su-keerthi/5_Bit_Carry_Lookahead_Adder/Report/VLSI COURSE PROJECT.pdf

VLSI COURSE PROJECT

CARRY LOOK-AHEAD ADDER

Sukeerthi Kattamuri

Roll No. 2024102074

I. INTRODUCTION

Addition is a fundamental operation required in digital circuits. One common approach for performing addition is the ripple-carry adder, where the carry output from each full adder is passed to the next stage. However, this introduces significant propagation delay because every stage must wait for the carry from the previous one.

To overcome this delay, a carry look-ahead adder (CLA) is used. In a CLA, carries are computed directly from the input bits using digital logic. This avoids the sequential delay seen in ripple adders and results in much faster computation

The basic circuit diagram is given below

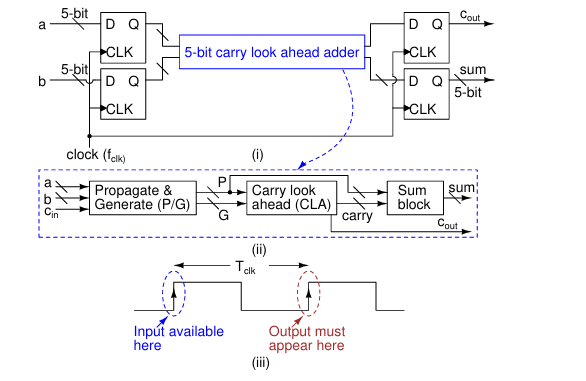
[picture p1: figure]

CLA uses two signals for each bit position:

Propagate: Pi = Ai ⊕ Bi

Generate: Gi = Ai · Bi

Using these signals, the carry-out of each stage is expressed as: Ci+1 = Gi + Pi · Ci. We can recursively calculate the carry bit for each bit using this formula as done below.

C1 = g1 + p1·C0

C2 = g2 + p2·C1 = g2 + p2·g1 + p2·p1·C0

C3 = g3 + p3·C2 = g3 + p3·g2 + p3·p2·g1 + p3·p2·p1·C0

C4 = g4 + p4·C3 = g4 + p4·g3 + p4·p3·g2 + p4·p3·p2·g1 + p4·p3·p2·p1·C0

C5 = g5 + p5·C4 = g5 + p5·g4 + p5·p4·g3 + p5·p4·p3·g2 + p5·p4·p3·p2·g1 + p5·p4·p3·p2·p1·C0

Once the carries are computed, we can calculate all the sum bits.

Si = Pi ⊕ Ci−1

IIA. CLA DESIGN TOPOLOGY

Here we use static CMOS implementation to make the required logic gates. We require multiple input gates for preforming these computations. This can either be implemented by using a single multiple input gate or by using multiple dual input gates. After analysis of ngSpice simulation, there was less delay from using dual input gates. Hence all the required gates AND(input 2, 3, 4, 5, 6), OR(input 2, 3, 4, 5, 6), NOT and XOR were implemented using static CMOS logic.

The reason for preferring this logic style over other dynamic styles is that we require for the output to be computed within one clock cycle, this is difficult to achieve through dynamic implementations. Dynamic logic also has the risk of charge leakage. Also dynamic logic requires a precharge and evaluation phase which lead to excessive power consumption that is not preferred.

Other advantages of the CMOS style are its simple and straightforward design. Moreover it has high noise margins, giving a more robust implementation.

The basic circuit that we used can be divided into three blocks. The first block consists if flip-flops. The implementation used here is a TSPC (True Single Phase Clock) flip-flop. The flip-flop ensures that the input bits are all given simultaneously to the adder to prevent any glitches. In the next stage, the logic signals discussed above are implemented using static CMOS designed gates. The carry bits are all computed simultaneously without needing to wait for previous computations. Once the sum bits and final carry bit is generated, they are stored in another set of flip-flops, so that the results can be used at the next rising clock edge.

The circuit implemented for the TSPC is flip-flop is given below.

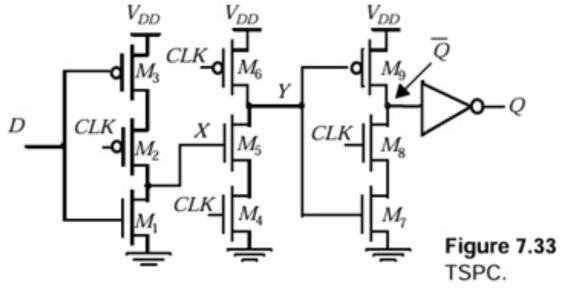
[picture p2: figure]

II.B CLA TRANSISTOR SIZING

Minimum sizing MOSFETS are used. λ = 0.09 μm is taken. We are required that for the NOT gate WP / WN = 2.

OR gates are implemented by using a NOR gate followed by an inverter and similarly AND gates are implemented using a NAND gate followed by an inverter.

Gate | NMOS | PMOS
NOT | 900 nm | 1800 nm
NOR – 2 input | 900 nm | 3600 nm
NOR – 3 input | 900 nm | 5400 nm
NOR – 4 input | 900 nm | 7200 nm
NOR – 5 input | 900 nm | 9000 nm
NOR – 6 input | 900 nm | 10800 nm
NAND – 2 input | 1800 nm | 1800 nm
NAND – 3 input | 2700 nm | 1800 nm
NAND – 4 input | 3600 nm | 1800 nm
NAND – 5 input | 4500 nm | 1800 nm
NAND – 6 input | 5400 nm | 1800 nm
XOR – 2 input | 1800 nm | 3600 nm
TSPC Flip Flop | 900 nm | 1800 nm

III. NSPICE SIMULATIONS

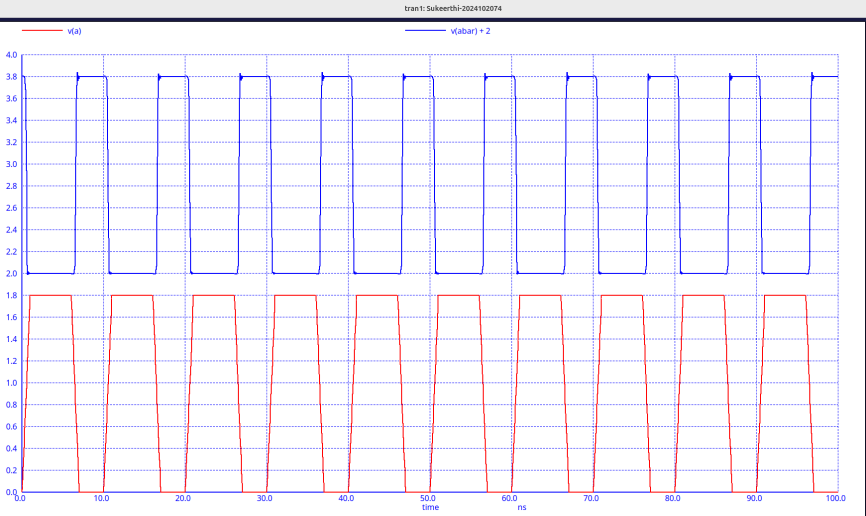
[picture p3: figure]

Inverter

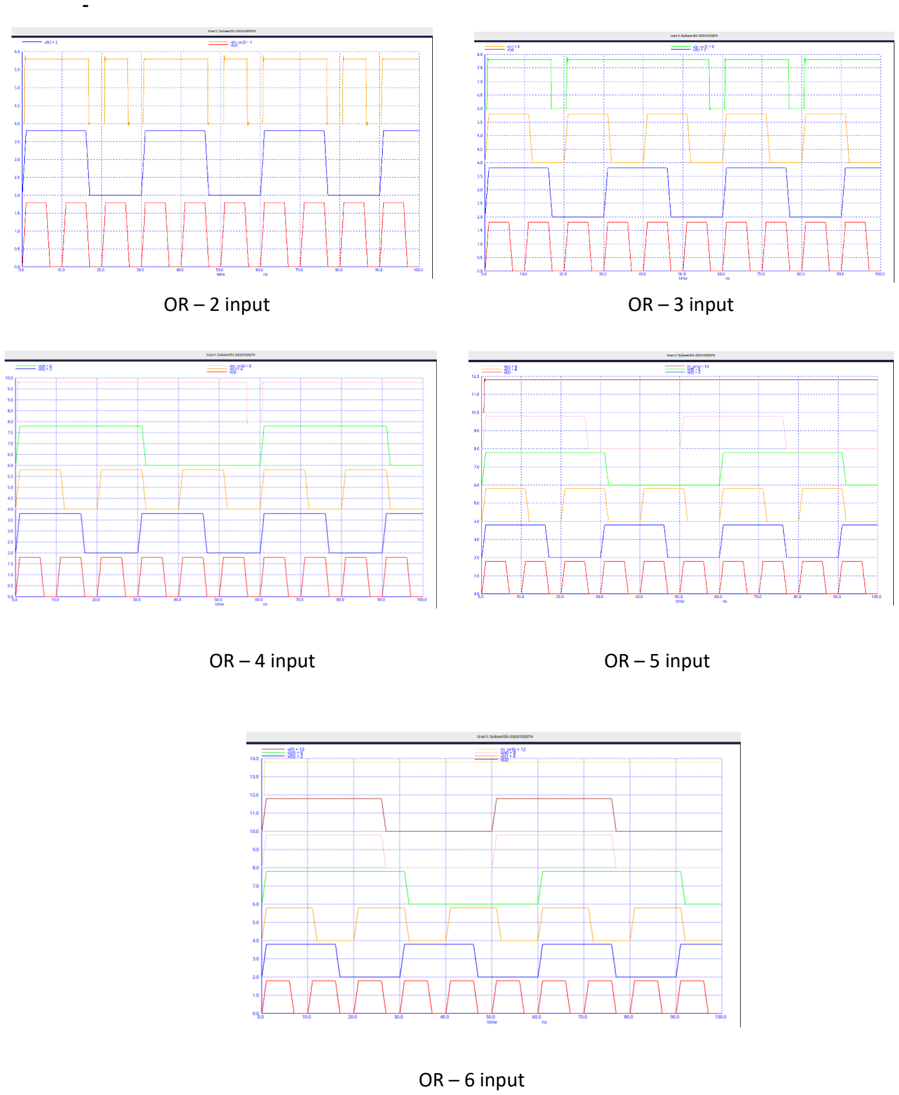
[picture p4: page 4]

OR – 2 input | OR – 3 input
OR – 4 input | OR – 5 input

OR – 6 input

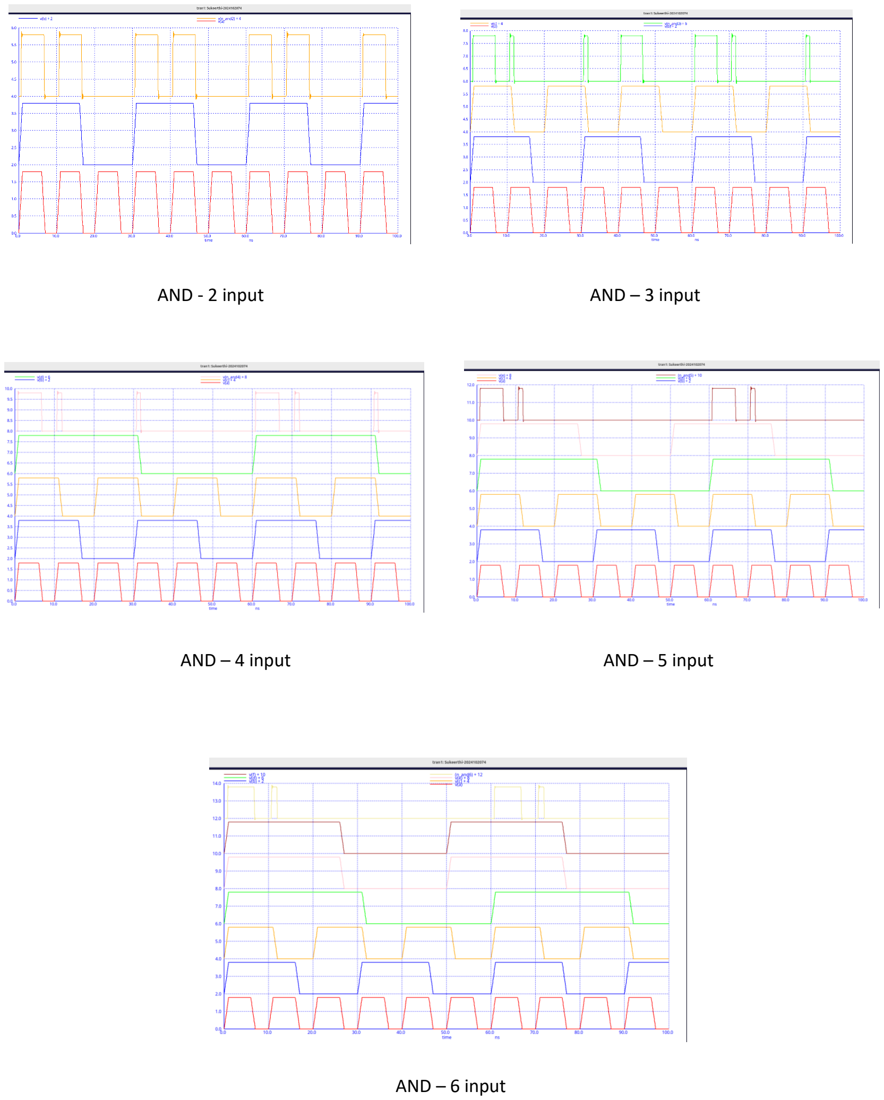
[picture p5: page 5]

AND - 2 input | AND – 3 input
AND – 4 input | AND – 5 input

AND – 6 input

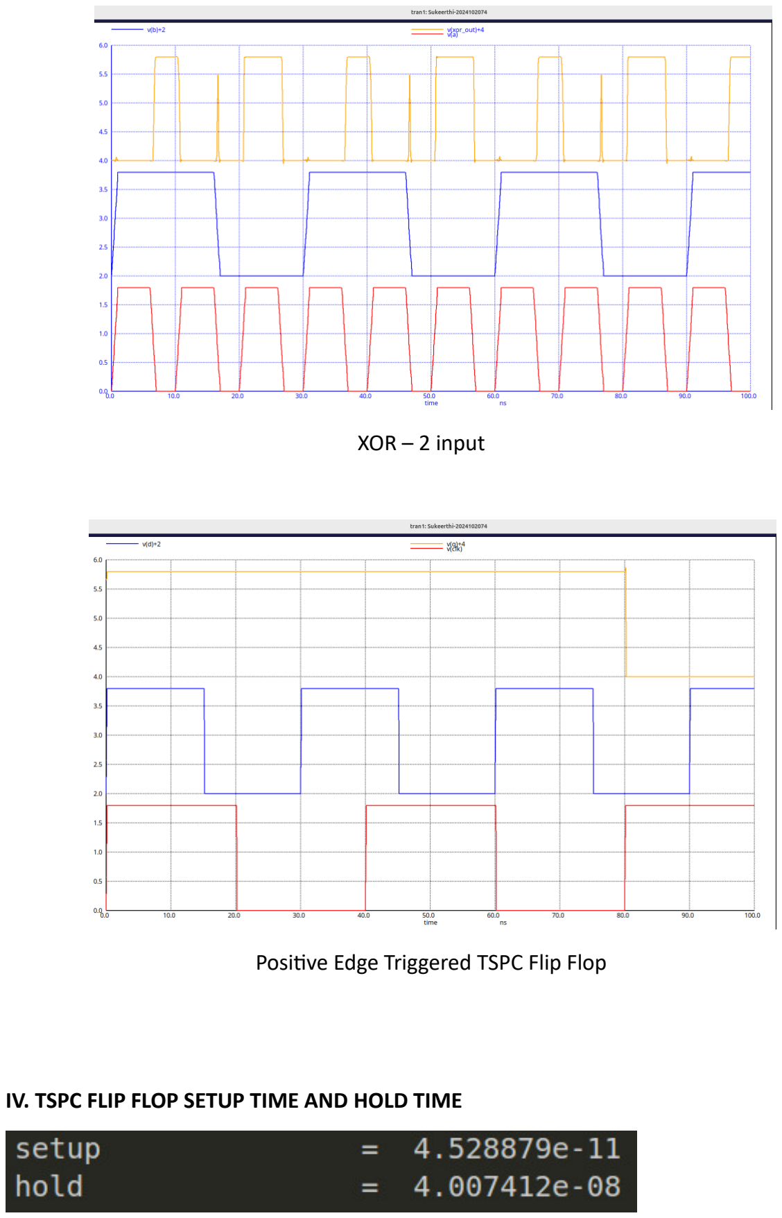
[picture p6: page 6]

XOR – 2 input

Positive Edge Triggered TSPC Flip Flop

IV. TSPC FLIP FLOP SETUP TIME AND HOLD TIME

V. STICK DIAGRAMS FOR IMPLEMENTATION

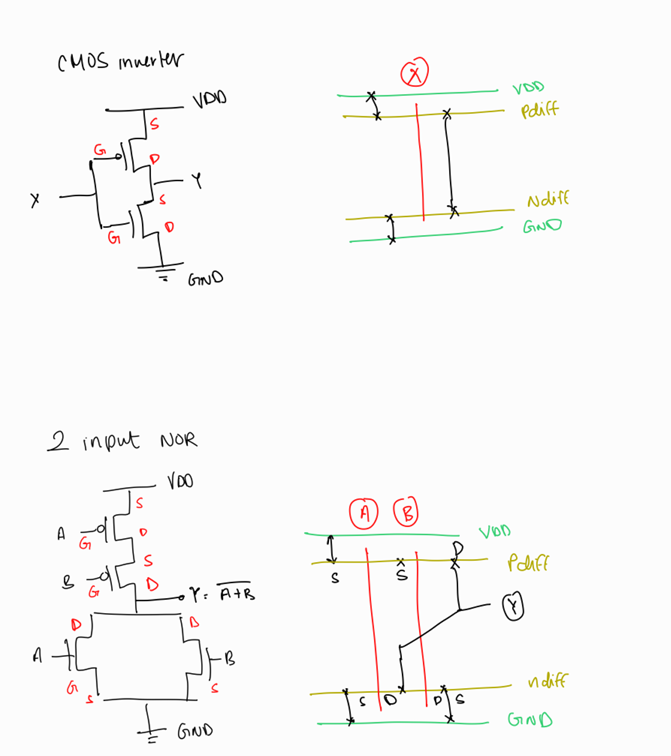
[picture p7: figure]

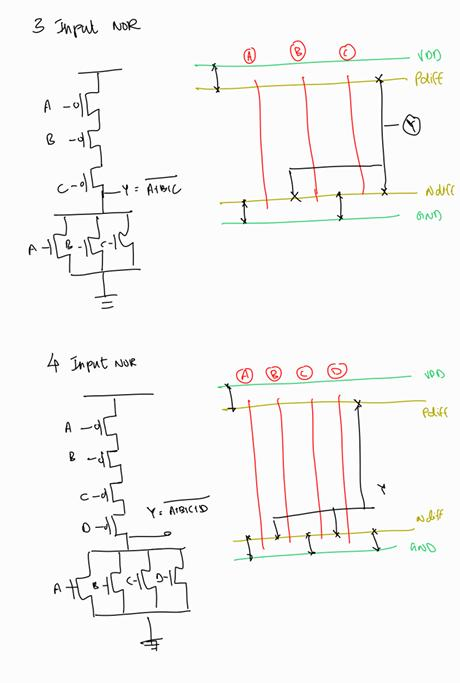
[picture p8: figure]

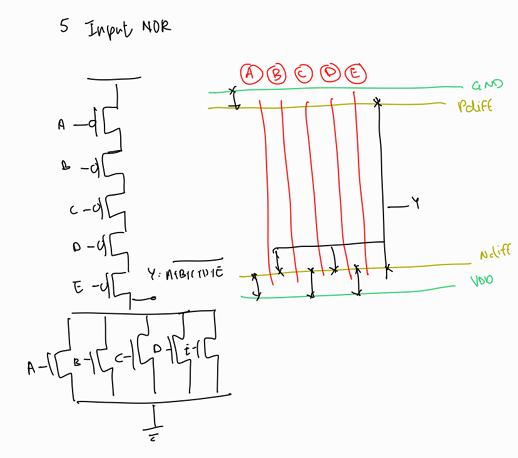
[picture p9: figure]

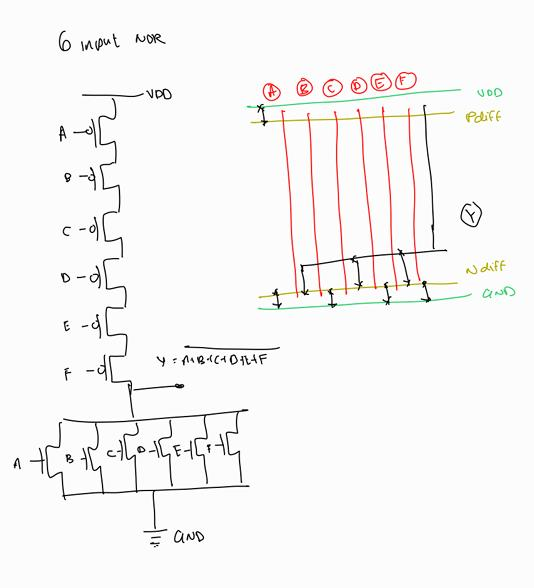
[picture p10: figure]

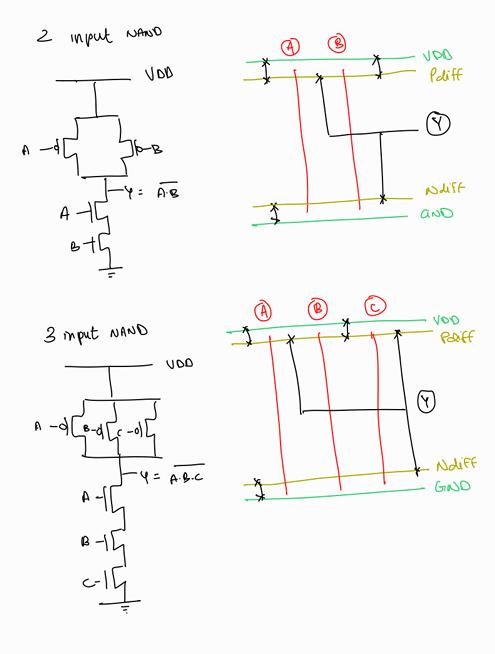
[picture p11: figure]

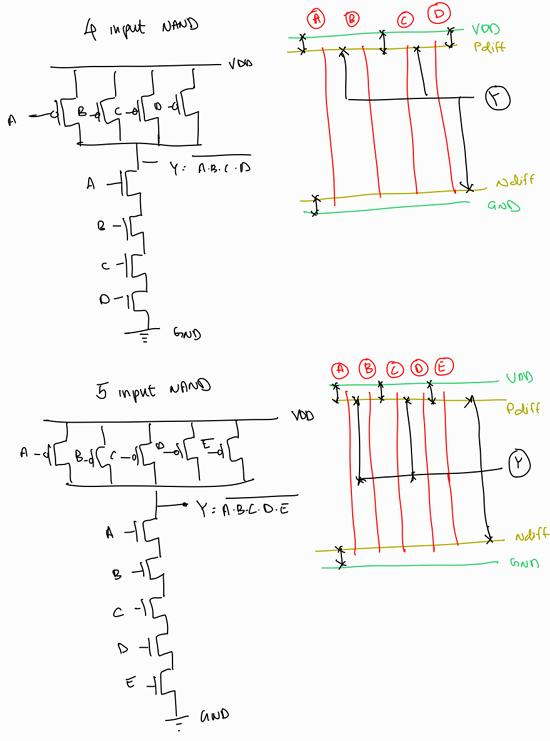
[picture p12: figure]

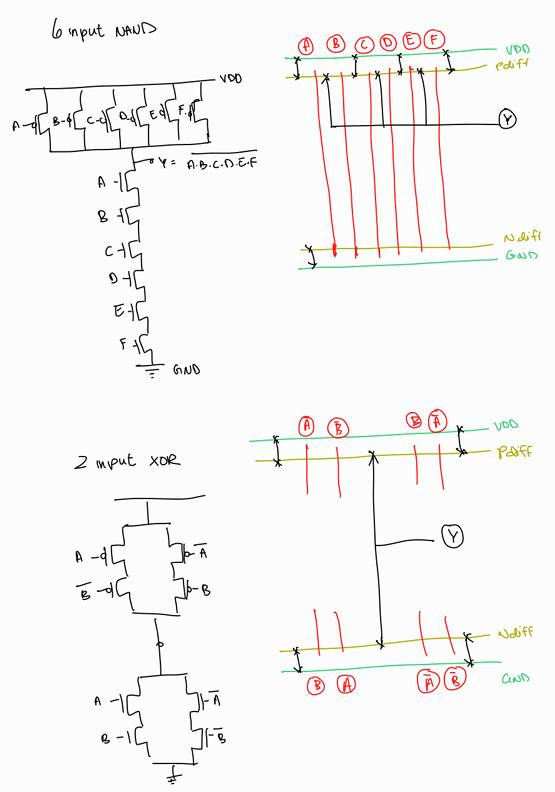
[picture p13: figure]
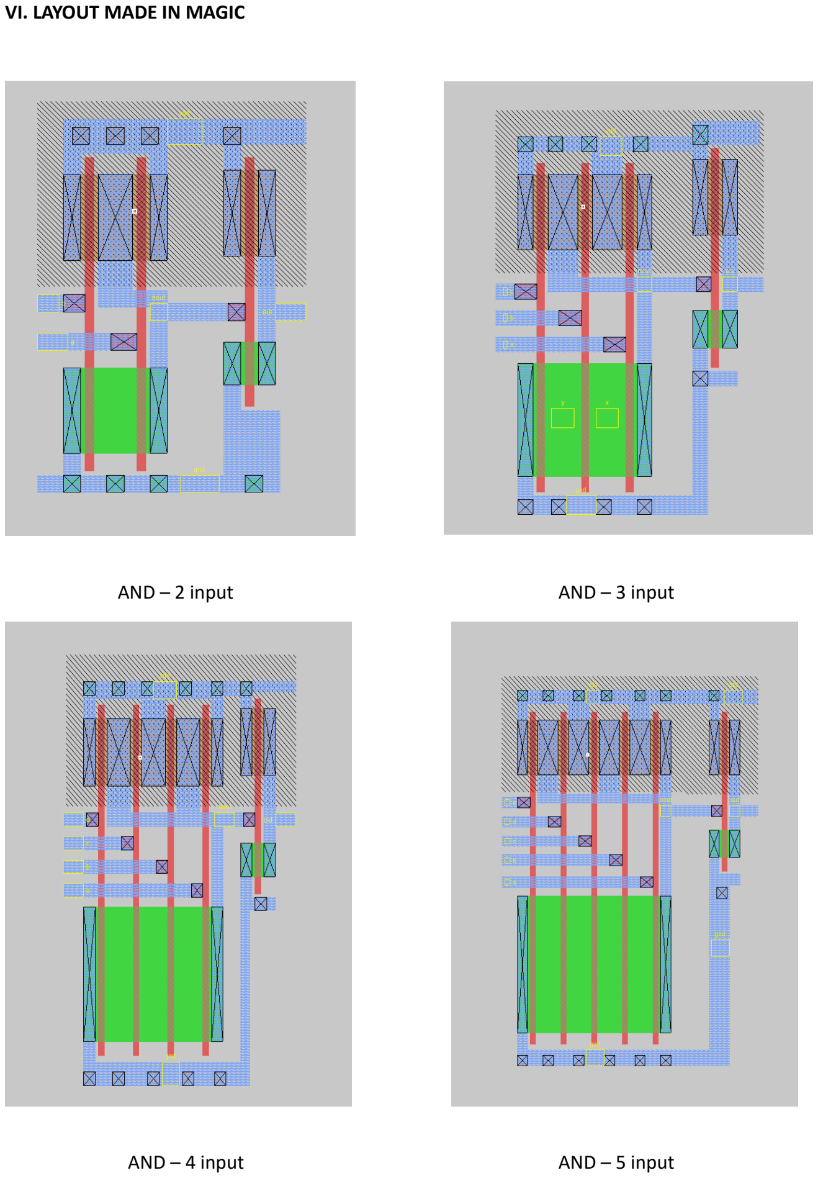
[picture p14: page 14]

VI. LAYOUT MADE IN MAGIC

AND – 2 input | AND – 3 input
AND – 4 input | AND – 5 input

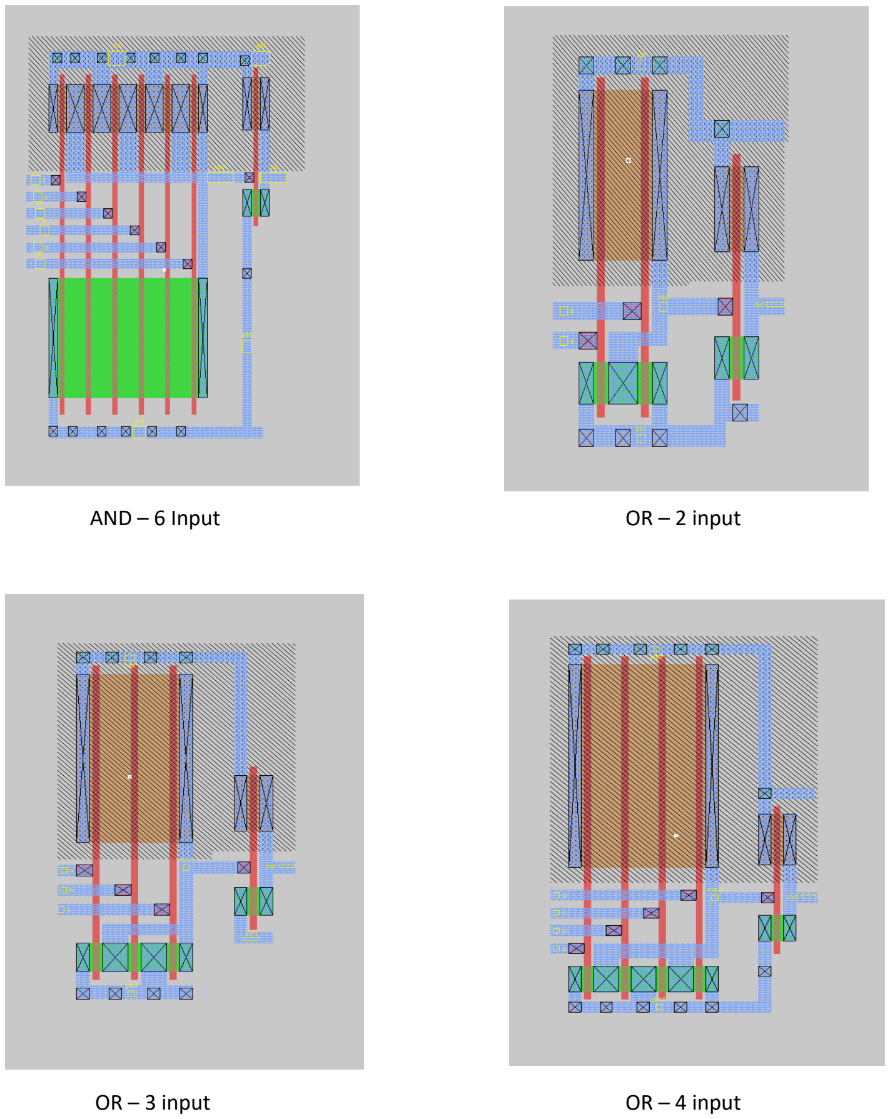
[picture p15: page 15]

AND – 6 Input | OR – 2 input
OR – 3 input | OR – 4 input

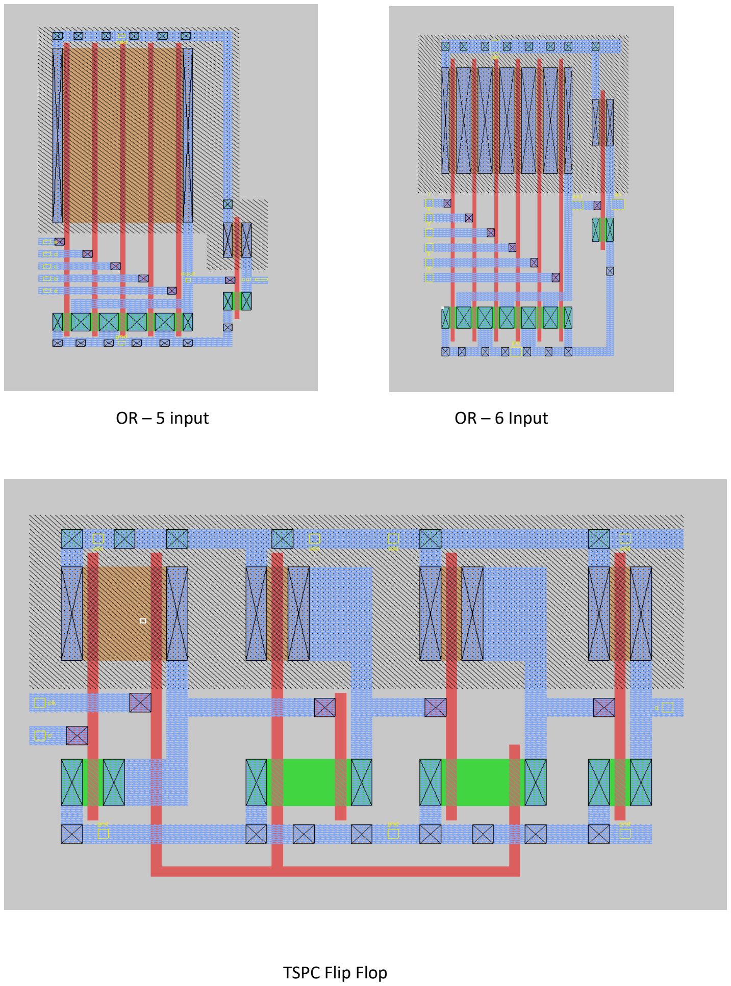
[picture p16: page 16]

OR – 5 input | OR – 6 Input

TSPC Flip Flop

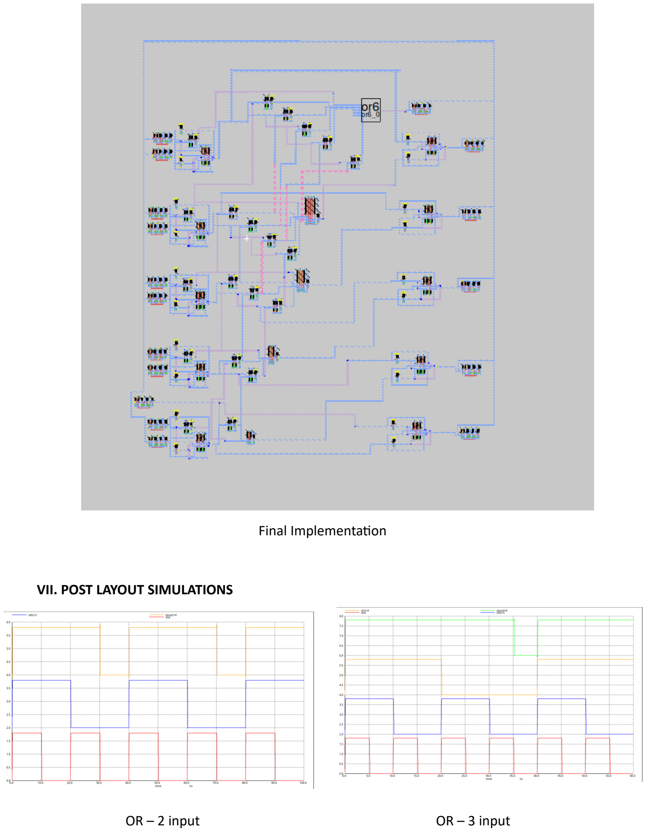
[picture p17: page 17]

Final Implementation

VII. POST LAYOUT SIMULATIONS

OR – 2 input | OR – 3 input

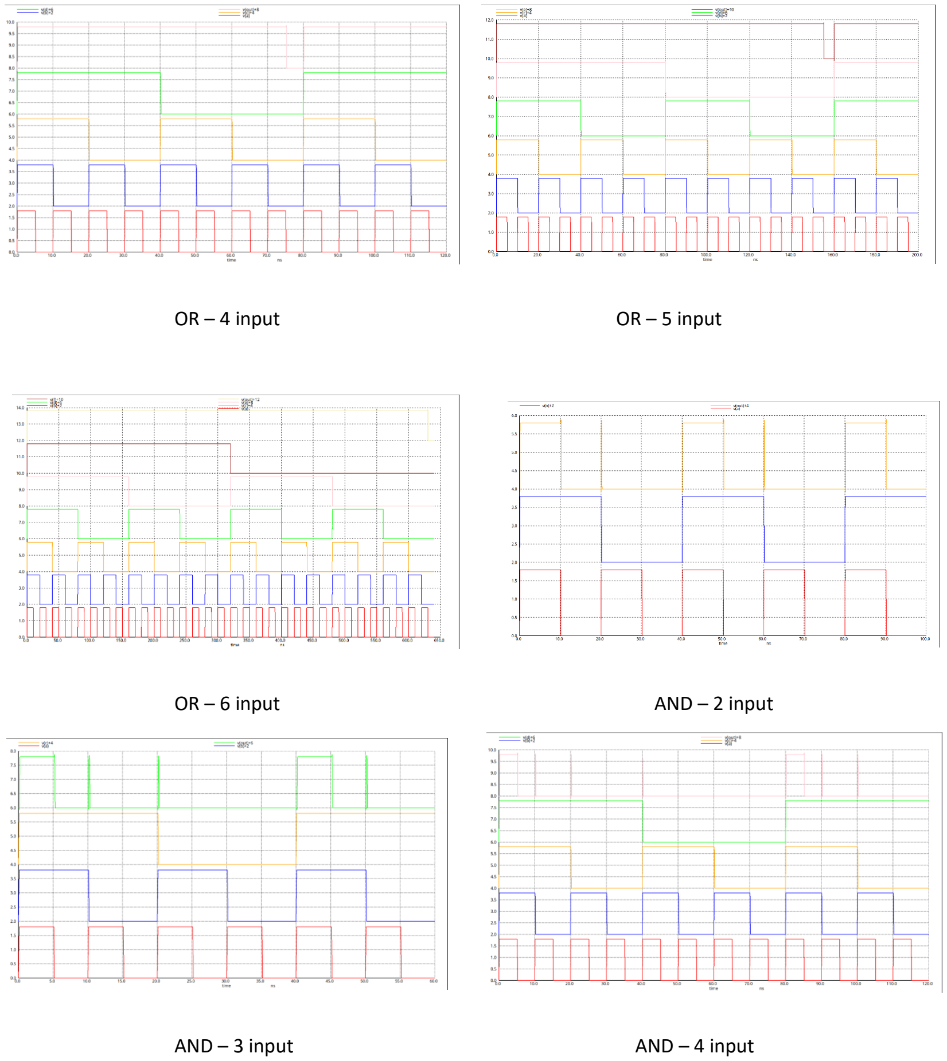
[picture p18: page 18]

OR – 4 input | OR – 5 input
OR – 6 input | AND – 2 input
AND – 3 input | AND – 4 input

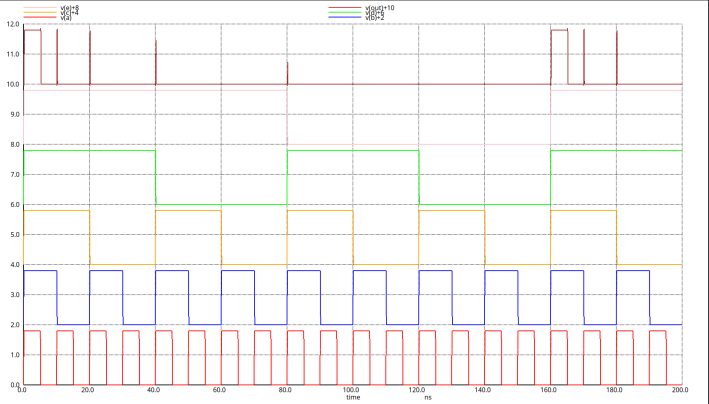
[picture p19: figure]
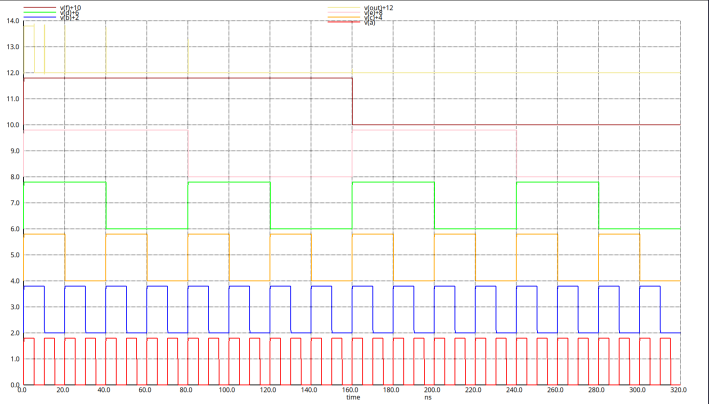
[picture p20: figure]

AND – 5 input | AND – 6 input

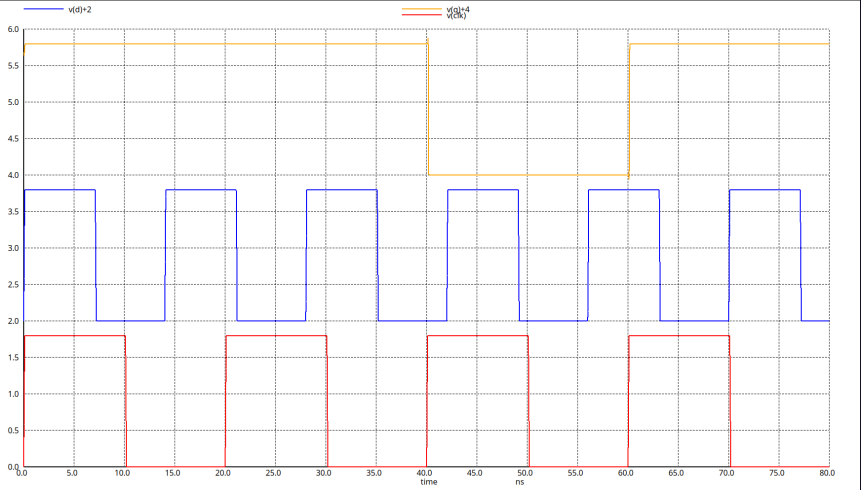
[picture p21: figure]

TSPC Flip Flop Output

IX. FULL CIRCUIT

A. PRE-LAYOUT

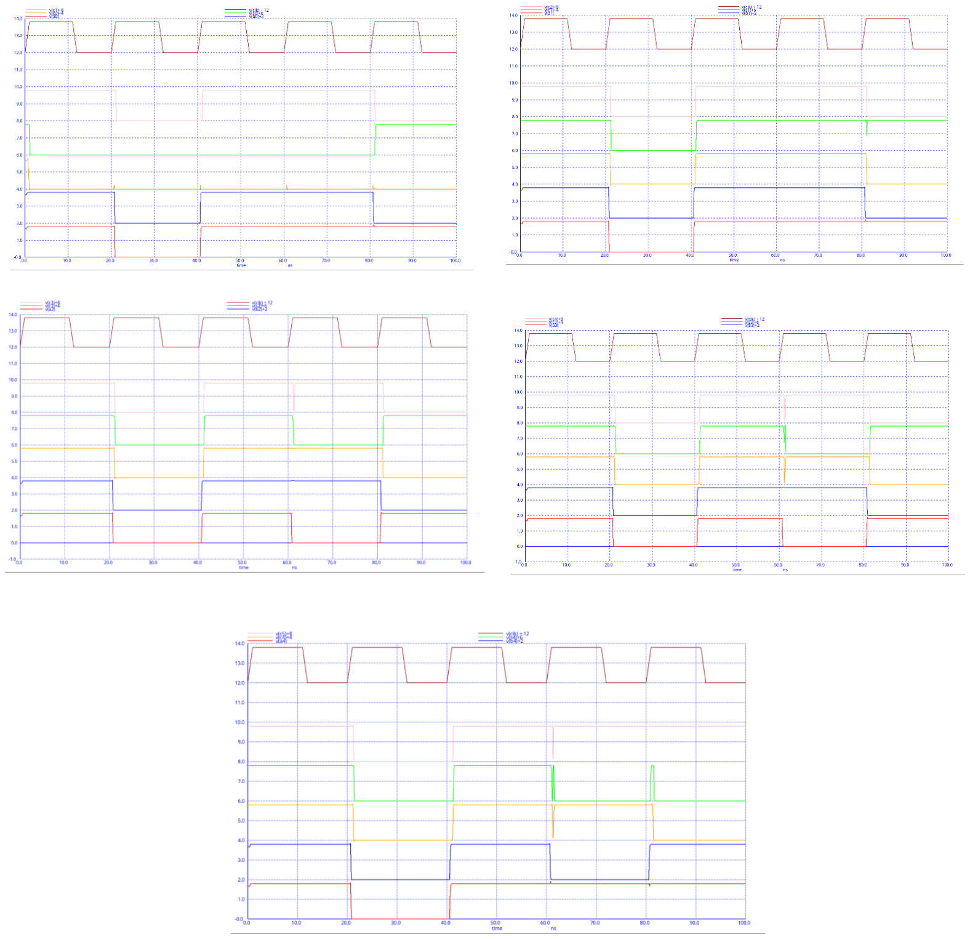
[picture p22: page 20]
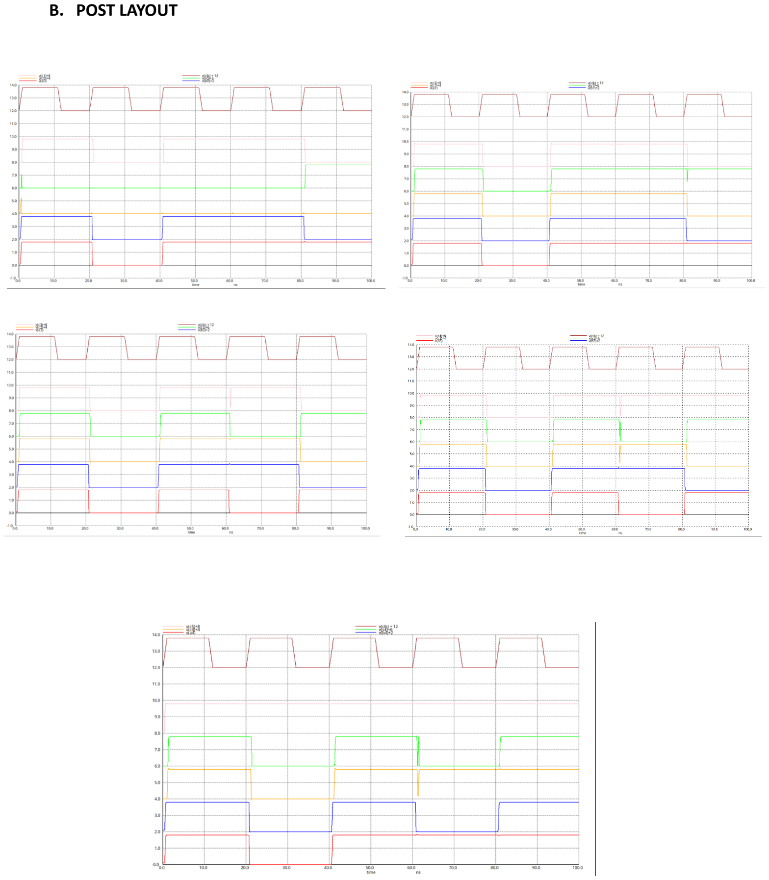
[picture p23: page 21]

B. POST LAYOUT

VIII. FLOOR PLAN

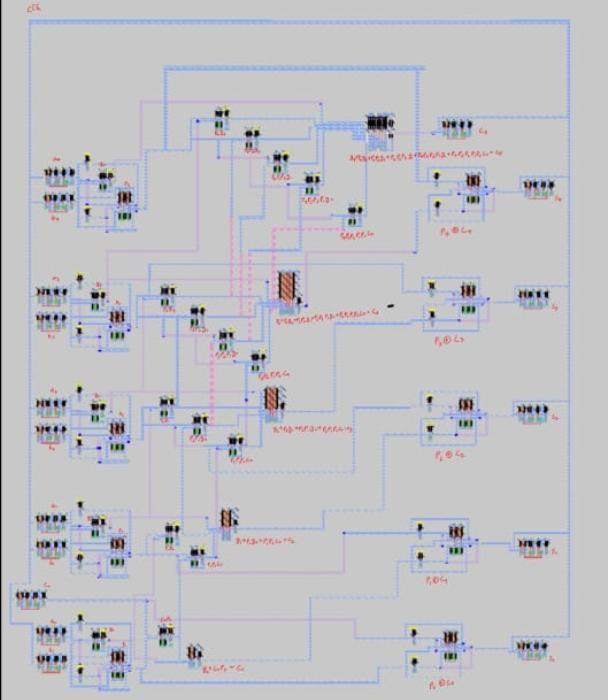
[picture p24: figure]

XI. VERILOG

The GTK wave from the Verilog code is given below:

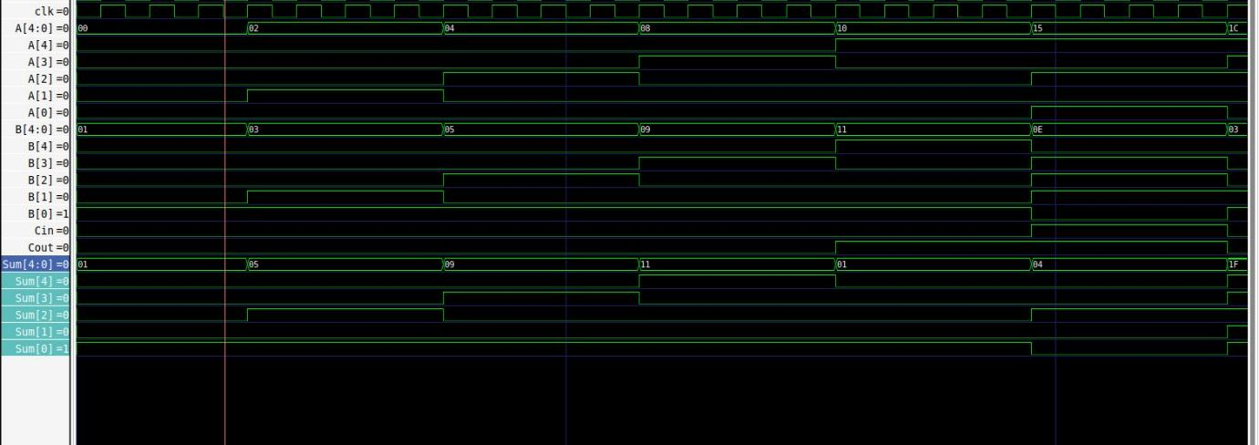
[picture p25: figure]

XII. FPGA Implementation

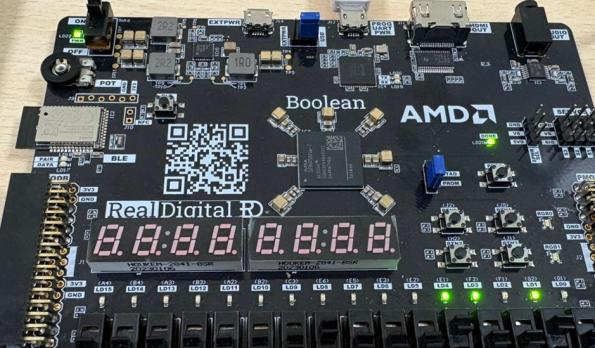
[picture p26: figure]
