su-keerthi/5_Bit_Carry_Lookahead_Adder/NGSPICE/Timing Diagrams/and_3_input.png

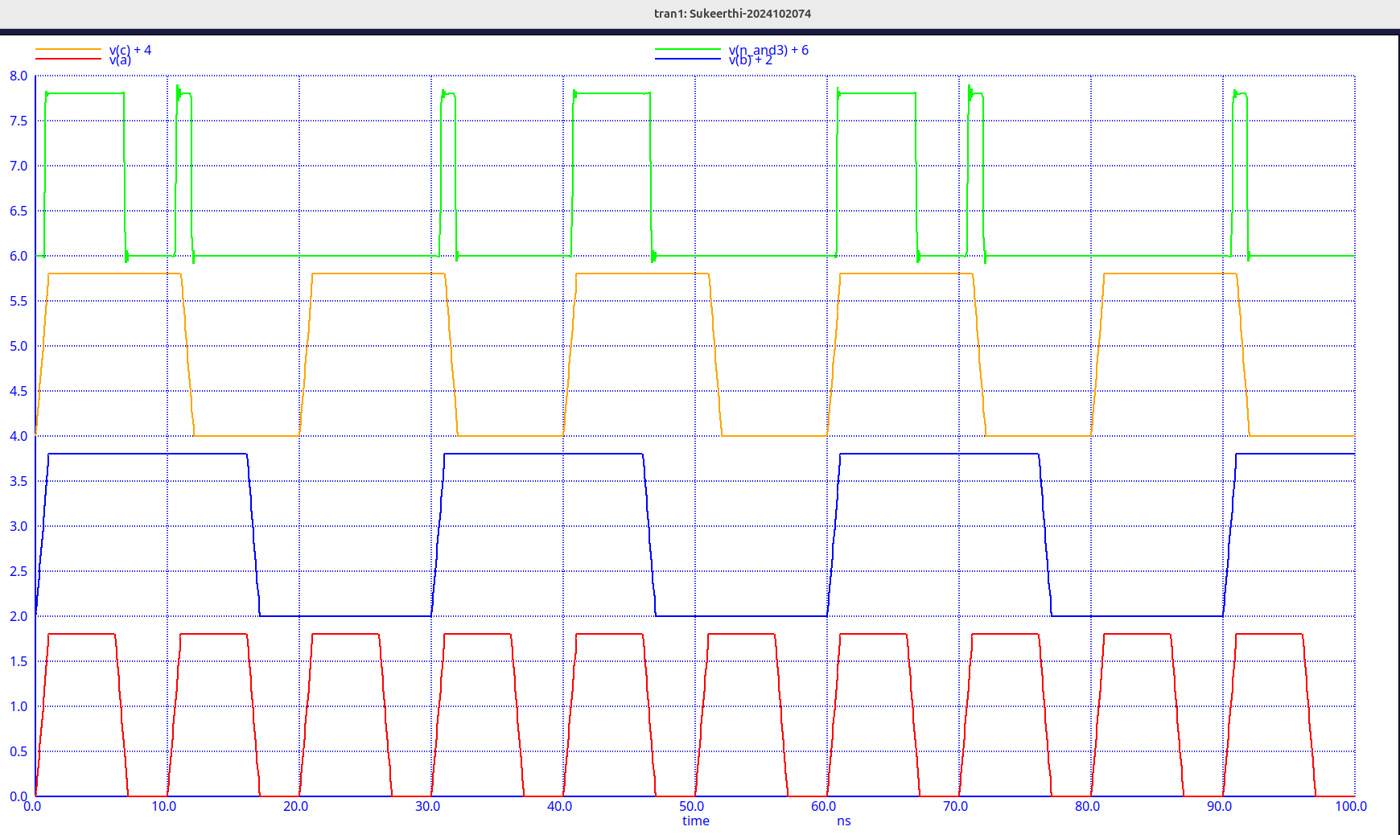
NGSPICE/Timing Diagrams/and_3_input.png
