su-keerthi/5_Bit_Carry_Lookahead_Adder/NGSPICE/Timing Diagrams/xor.png

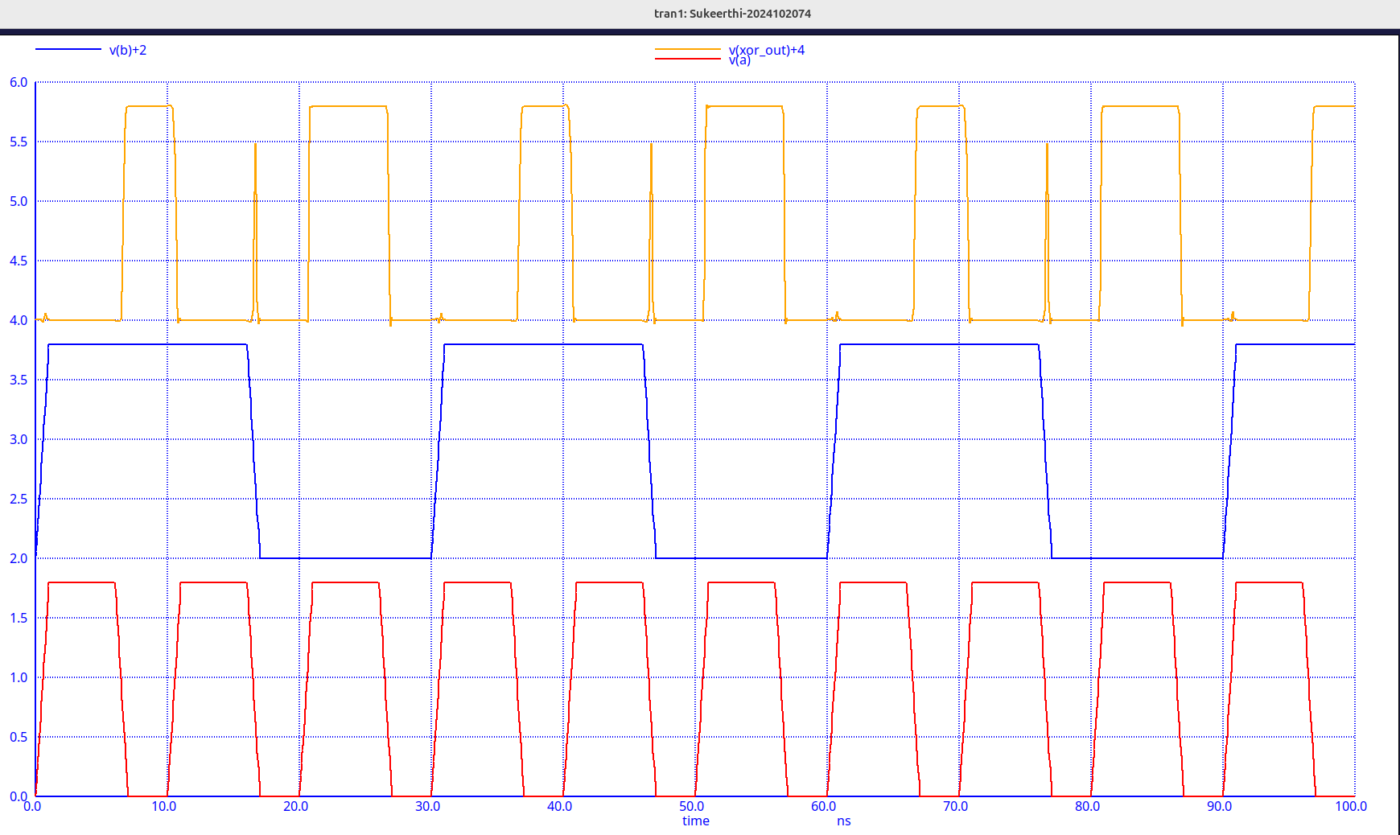
NGSPICE/Timing Diagrams/xor.png
