su-keerthi/5_Bit_Carry_Lookahead_Adder/NGSPICE/Codes/final_post.cir

.include TSMC_180nm.txt
.param SUPPLY=1.8
.global gnd vdd
Vdd vdd gnd 'SUPPLY'
.option scale=90n

vclk clk gnd pulse 0 1.8 0 1ns 1ns 10ns 20ns

va0 a0d gnd pulse 0 1.8 0 1ns 1ns 13ns 26ns
va1 a1d gnd pulse 0 1.8 0 1ns 1ns 13ns 26ns
va2 a2d gnd pulse 0 1.8 0 1ns 1ns 17ns 34ns
va3 a3d gnd pulse 0 1.8 0 1ns 1ns 17ns 34ns
va4 a4d gnd pulse 0 1.8 0 1ns 1ns 13ns 26ns

vb0 b0d gnd pulse 0 1.8 0 1ns 1ns 15ns 30ns
vb1 b1d gnd pulse 0 1.8 0 1ns 1ns 15ns 30ns
vb2 b2d gnd pulse 0 1.8 0 1ns 1ns 15ns 30ns
vb3 b3d gnd pulse 0 1.8 0 1ns 1ns 15ns 30ns
vb4 b4d gnd pulse 0 1.8 0 1ns 1ns 17ns 34ns

vc0 c0d gnd 0

M1000 s2 a_967_n288# a_1095_n353# Gnd CMOSN w=20 l=2
+  ad=200 pd=60 as=200 ps=60
M1001 a_n597_n1325# clk a_n597_n1294# vdd CMOSP w=20 l=2
+  ad=100 pd=50 as=200 ps=60
M1002 b3 a_n530_72# gnd Gnd CMOSN w=10 l=2
+  ad=50 pd=30 as=11580 ps=6980
M1003 p3g2 a_n99_178# vdd w_n112_172# CMOSP w=20 l=2
+  ad=100 pd=50 as=21880 ps=11280
M1004 a_140_n753# g1 vdd vdd CMOSP w=60 l=2
+  ad=600 pd=140 as=0 ps=0
M1005 p3 b3bar a_n302_65# vdd CMOSP w=40 l=2
+  ad=400 pd=100 as=400 ps=100
M1006 a_1081_n862# c1 s1 Gnd CMOSN w=20 l=2
+  ad=200 pd=60 as=200 ps=60
M1007 a_n102_n267# g1 a_n102_n312# Gnd CMOSN w=20 l=2
+  ad=100 pd=50 as=200 ps=60
M1008 a_n563_n1184# clk vdd vdd CMOSP w=20 l=2
+  ad=100 pd=50 as=0 ps=0
M1009 a_n530_n1184# a_n563_n1184# vdd vdd CMOSP w=20 l=2
+  ad=100 pd=50 as=0 ps=0
M1010 a_1335_133# clk a_1335_164# vdd CMOSP w=20 l=2
+  ad=100 pd=50 as=200 ps=60
M1011 a4 a_n498_653# gnd Gnd CMOSN w=10 l=2
+  ad=50 pd=30 as=0 ps=0
M1012 a_1064_844# a_1029_813# a_1064_813# Gnd CMOSN w=10 l=2
+  ad=50 pd=30 as=100 ps=40
M1013 a_n563_72# clk vdd vdd CMOSP w=20 l=2
+  ad=100 pd=50 as=0 ps=0
M1014 a_n349_640# a4 vdd w_n362_634# CMOSP w=20 l=2
+  ad=200 pd=60 as=0 ps=0
M1015 a_n380_n286# a2 vdd w_n393_n292# CMOSP w=20 l=2
+  ad=200 pd=60 as=0 ps=0
M1016 vdd a_998_494# a_1148_610# vdd CMOSP w=40 l=2
+  ad=0 pd=0 as=400 ps=100
M1017 a_370_161# g3 vdd vdd CMOSP w=100 l=2
+  ad=1000 pd=220 as=0 ps=0
M1018 a_n278_0# b3bar p3 Gnd CMOSN w=20 l=2
+  ad=200 pd=60 as=200 ps=60
M1019 a_n566_622# clk a_n566_653# vdd CMOSP w=20 l=2
+  ad=100 pd=50 as=200 ps=60
M1020 gnd a1bar a_n277_n908# Gnd CMOSN w=20 l=2
+  ad=0 pd=0 as=200 ps=60
M1021 p3p2g1 a_20_97# gnd Gnd CMOSN w=10 l=2
+  ad=50 pd=30 as=0 ps=0
M1022 c4 a_370_99# gnd Gnd CMOSN w=10 l=2
+  ad=50 pd=30 as=0 ps=0
M1023 a_1403_n833# a_1370_n833# vdd vdd CMOSP w=20 l=2
+  ad=100 pd=50 as=0 ps=0
M1024 p0c0 a_n108_n1183# vdd w_n121_n1189# CMOSP w=20 l=2
+  ad=100 pd=50 as=0 ps=0
M1025 a_263_n131# p3 gnd Gnd CMOSN w=20 l=2
+  ad=200 pd=60 as=0 ps=0
M1026 a_n598_41# clk a_n598_72# vdd CMOSP w=20 l=2
+  ad=100 pd=50 as=200 ps=60
M1027 a_n562_n1325# clk gnd Gnd CMOSN w=10 l=2
+  ad=100 pd=40 as=0 ps=0
M1028 vdd a1bar a_n277_n843# vdd CMOSP w=40 l=2
+  ad=0 pd=0 as=400 ps=100
M1029 a_n529_n1325# a_n562_n1294# gnd Gnd CMOSN w=10 l=2
+  ad=100 pd=40 as=0 ps=0
M1030 gnd p2p1g0 a_316_n332# Gnd CMOSN w=10 l=2
+  ad=0 pd=0 as=200 ps=80
M1031 a_n498_653# a_n531_653# vdd vdd CMOSP w=20 l=2
+  ad=100 pd=50 as=0 ps=0
M1032 a_n300_n1297# a0 vdd vdd CMOSP w=40 l=2
+  ad=400 pd=100 as=0 ps=0
M1033 a_969_n404# c2 vdd w_955_n381# CMOSP w=20 l=2
+  ad=100 pd=50 as=0 ps=0
M1034 a_1423_604# a_1390_604# vdd vdd CMOSP w=20 l=2
+  ad=100 pd=50 as=0 ps=0
M1035 a_1057_n1220# c0 s0 vdd CMOSP w=40 l=2
+  ad=400 pd=100 as=400 ps=100
M1036 a_20_n868# p1 vdd w_7_n874# CMOSP w=20 l=2
+  ad=200 pd=60 as=0 ps=0
M1037 a_n598_n868# clk a_n598_n837# vdd CMOSP w=20 l=2
+  ad=100 pd=50 as=200 ps=60
M1038 a_140_n799# p1p0c0 a_152_n753# vdd CMOSP w=60 l=2
+  ad=300 pd=130 as=600 ps=140
M1039 a_n248_544# b4 p4 vdd CMOSP w=40 l=2
+  ad=400 pd=100 as=400 ps=100
M1040 a_340_n283# p2g1 a_328_n283# vdd CMOSP w=80 l=2
+  ad=800 pd=180 as=800 ps=180
M1041 a_n530_n837# a_n563_n837# vdd vdd CMOSP w=20 l=2
+  ad=100 pd=50 as=0 ps=0
M1042 vdd p1g0 a_29_n339# w_16_n345# CMOSP w=20 l=2
+  ad=0 pd=0 as=200 ps=60
M1043 a_n533_520# clk gnd Gnd CMOSN w=10 l=2
+  ad=100 pd=40 as=0 ps=0
M1044 a_1355_573# clk a_1355_604# vdd CMOSP w=20 l=2
+  ad=100 pd=50 as=200 ps=60
M1045 a_967_n288# p2 vdd w_953_n265# CMOSP w=20 l=2
+  ad=100 pd=50 as=0 ps=0
M1046 p1 a1 a_n301_n908# Gnd CMOSN w=20 l=2
+  ad=200 pd=60 as=200 ps=60
M1047 a0bar a0 gnd Gnd CMOSN w=10 l=2
+  ad=50 pd=30 as=0 ps=0
M1048 a_n598_n1215# clk a_n598_n1184# vdd CMOSP w=20 l=2
+  ad=100 pd=50 as=200 ps=60
M1049 a_1097_844# clk a_1097_813# Gnd CMOSN w=10 l=2
+  ad=50 pd=30 as=100 ps=40
M1050 s1 c1 a_1057_n797# vdd CMOSP w=40 l=2
+  ad=400 pd=100 as=400 ps=100
M1051 b3bar b3 gnd Gnd CMOSN w=10 l=2
+  ad=50 pd=30 as=0 ps=0
M1052 p1 b1bar a_n301_n843# vdd CMOSP w=40 l=2
+  ad=400 pd=100 as=400 ps=100
M1053 p3p2p1g0 a_135_1# gnd Gnd CMOSN w=10 l=2
+  ad=50 pd=30 as=0 ps=0
M1054 gnd g2 a_316_n332# Gnd CMOSN w=10 l=2
+  ad=0 pd=0 as=0 ps=0
M1055 vdd b2 a_n380_n286# w_n393_n292# CMOSP w=20 l=2
+  ad=0 pd=0 as=0 ps=0
M1056 a_n561_174# a_n596_143# a_n561_143# Gnd CMOSN w=10 l=2
+  ad=50 pd=30 as=100 ps=40
M1057 a_1400_n328# a_1367_n297# gnd Gnd CMOSN w=10 l=2
+  ad=100 pd=40 as=0 ps=0
M1058 b4bar b4 vdd w_n419_490# CMOSP w=20 l=2
+  ad=100 pd=50 as=0 ps=0
M1059 a_1403_n864# a_1370_n833# gnd Gnd CMOSN w=10 l=2
+  ad=100 pd=40 as=0 ps=0
M1060 a_n596_143# a3d gnd Gnd CMOSN w=10 l=2
+  ad=50 pd=30 as=0 ps=0
M1061 p3p2p1g0 a_135_1# vdd w_122_n5# CMOSP w=20 l=2
+  ad=100 pd=50 as=0 ps=0
M1062 s3q a_1403_164# gnd Gnd CMOSN w=10 l=2
+  ad=50 pd=30 as=0 ps=0
M1063 a_n598_72# b3d vdd vdd CMOSP w=20 l=2
+  ad=0 pd=0 as=0 ps=0
M1064 g4 a_n349_640# vdd w_n362_634# CMOSP w=20 l=2
+  ad=100 pd=50 as=0 ps=0
M1065 a_n563_n1215# clk gnd Gnd CMOSN w=10 l=2
+  ad=100 pd=40 as=0 ps=0
M1066 g1 a_n378_n747# gnd Gnd CMOSN w=10 l=2
+  ad=50 pd=30 as=0 ps=0
M1067 a_n530_n1215# a_n563_n1184# gnd Gnd CMOSN w=10 l=2
+  ad=100 pd=40 as=0 ps=0
M1068 b4 a_n500_551# gnd Gnd CMOSN w=10 l=2
+  ad=50 pd=30 as=0 ps=0
M1069 a_1119_n353# c2 s2 Gnd CMOSN w=20 l=2
+  ad=200 pd=60 as=0 ps=0
M1070 p2p1g0 a_29_n339# vdd w_16_n345# CMOSP w=20 l=2
+  ad=100 pd=50 as=0 ps=0
M1071 a_135_n44# p3 gnd Gnd CMOSN w=20 l=2
+  ad=200 pd=60 as=0 ps=0
M1072 a_905_n1220# c0 gnd Gnd CMOSN w=10 l=2
+  ad=50 pd=30 as=0 ps=0
M1073 gnd p1g0 a_140_n799# Gnd CMOSN w=10 l=2
+  ad=0 pd=0 as=150 ps=70
M1074 a_n528_174# a_n561_174# vdd vdd CMOSP w=20 l=2
+  ad=100 pd=50 as=0 ps=0
M1075 p0 a0 a_n300_n1362# Gnd CMOSN w=20 l=2
+  ad=200 pd=60 as=200 ps=60
M1076 s4q a_1423_604# gnd Gnd CMOSN w=10 l=2
+  ad=50 pd=30 as=0 ps=0
M1077 a_1097_813# a_1064_844# gnd Gnd CMOSN w=10 l=2
+  ad=0 pd=0 as=0 ps=0
M1078 a_n568_520# clk a_n568_551# vdd CMOSP w=20 l=2
+  ad=100 pd=50 as=200 ps=60
M1079 a_n530_n868# a_n563_n837# gnd Gnd CMOSN w=10 l=2
+  ad=100 pd=40 as=0 ps=0
M1080 vdd a_931_n913# a_1081_n797# vdd CMOSP w=40 l=2
+  ad=0 pd=0 as=400 ps=100
M1081 a_978_54# c3 gnd Gnd CMOSN w=10 l=2
+  ad=50 pd=30 as=0 ps=0
M1082 gnd c0 a_1057_n1285# Gnd CMOSN w=20 l=2
+  ad=0 pd=0 as=200 ps=60
M1083 p2g1 a_n102_n267# vdd w_n115_n273# CMOSP w=20 l=2
+  ad=100 pd=50 as=0 ps=0
M1084 a_n277_n908# b1bar p1 Gnd CMOSN w=20 l=2
+  ad=0 pd=0 as=0 ps=0
M1085 a_118_889# p4 vdd w_105_883# CMOSP w=20 l=2
+  ad=200 pd=60 as=0 ps=0
M1086 a_1029_844# a_1023_826# vdd vdd CMOSP w=20 l=2
+  ad=200 pd=60 as=0 ps=0
M1087 a_n500_551# a_n533_551# vdd vdd CMOSP w=20 l=2
+  ad=100 pd=50 as=0 ps=0
M1088 a_1370_133# clk gnd Gnd CMOSN w=10 l=2
+  ad=100 pd=40 as=0 ps=0
M1089 a_263_n86# p2p1p0c0 a_263_n131# Gnd CMOSN w=20 l=2
+  ad=100 pd=50 as=0 ps=0
M1090 a_n277_n843# b1 p1 vdd CMOSP w=40 l=2
+  ad=0 pd=0 as=0 ps=0
M1091 a_316_n332# p2g1 gnd Gnd CMOSN w=10 l=2
+  ad=0 pd=0 as=0 ps=0
M1092 b2bar b2 vdd w_n450_n436# CMOSP w=20 l=2
+  ad=100 pd=50 as=0 ps=0
M1093 a_n566_653# a4d vdd vdd CMOSP w=20 l=2
+  ad=0 pd=0 as=0 ps=0
M1094 a_1033_n1220# a_905_n1220# vdd vdd CMOSP w=40 l=2
+  ad=400 pd=100 as=0 ps=0
M1095 p4g3 a_118_889# vdd w_105_883# CMOSP w=20 l=2
+  ad=100 pd=50 as=0 ps=0
M1096 a_n102_n312# p2 gnd Gnd CMOSN w=20 l=2
+  ad=0 pd=0 as=0 ps=0
M1097 a_1390_573# clk gnd Gnd CMOSN w=10 l=2
+  ad=100 pd=40 as=0 ps=0
M1098 a_n598_n837# b1d vdd vdd CMOSP w=20 l=2
+  ad=0 pd=0 as=0 ps=0
M1099 a_29_n384# p2 gnd Gnd CMOSN w=20 l=2
+  ad=200 pd=60 as=0 ps=0
M1100 p1g0 a_n81_n776# gnd Gnd CMOSN w=10 l=2
+  ad=50 pd=30 as=0 ps=0
M1101 a_907_n1336# p0 gnd Gnd CMOSN w=10 l=2
+  ad=50 pd=30 as=0 ps=0
M1102 p3g2 a_n99_178# gnd Gnd CMOSN w=10 l=2
+  ad=50 pd=30 as=0 ps=0
M1103 a1bar a1 gnd Gnd CMOSN w=10 l=2
+  ad=50 pd=30 as=0 ps=0
M1104 a_n303_n447# b2 gnd Gnd CMOSN w=20 l=2
+  ad=200 pd=60 as=0 ps=0
M1105 a_140_n799# g1 gnd Gnd CMOSN w=10 l=2
+  ad=0 pd=0 as=0 ps=0
M1106 s2 c2 a_1095_n288# vdd CMOSP w=40 l=2
+  ad=400 pd=100 as=400 ps=100
M1107 vdd g0 a_n81_n776# w_n94_n782# CMOSP w=20 l=2
+  ad=0 pd=0 as=200 ps=60
M1108 a_n530_72# a_n563_72# vdd vdd CMOSP w=20 l=2
+  ad=100 pd=50 as=0 ps=0
M1109 a_931_n913# c1 vdd w_917_n890# CMOSP w=20 l=2
+  ad=100 pd=50 as=0 ps=0
M1110 a_n530_n837# clk a_n530_n868# Gnd CMOSN w=10 l=2
+  ad=50 pd=30 as=0 ps=0
M1111 g0 a_n377_n1201# gnd Gnd CMOSN w=10 l=2
+  ad=50 pd=30 as=0 ps=0
M1112 a_n303_n382# a2 vdd vdd CMOSP w=40 l=2
+  ad=400 pd=100 as=0 ps=0
M1113 a_n379_161# b3 a_n379_116# Gnd CMOSN w=20 l=2
+  ad=100 pd=50 as=200 ps=60
M1114 a_1081_n797# p1 s1 vdd CMOSP w=40 l=2
+  ad=0 pd=0 as=0 ps=0
M1115 a_n598_n304# clk a_n598_n273# vdd CMOSP w=20 l=2
+  ad=100 pd=50 as=200 ps=60
M1116 a_1064_844# clk vdd vdd CMOSP w=20 l=2
+  ad=100 pd=50 as=0 ps=0
M1117 a_929_n797# p1 vdd w_915_n774# CMOSP w=20 l=2
+  ad=100 pd=50 as=0 ps=0
M1118 a_1403_n833# clk a_1403_n864# Gnd CMOSN w=10 l=2
+  ad=50 pd=30 as=0 ps=0
M1119 a_118_844# p4 gnd Gnd CMOSN w=20 l=2
+  ad=200 pd=60 as=0 ps=0
M1120 a_n529_n1294# clk a_n529_n1325# Gnd CMOSN w=10 l=2
+  ad=50 pd=30 as=0 ps=0
M1121 a_n530_n273# a_n563_n273# vdd vdd CMOSP w=20 l=2
+  ad=100 pd=50 as=0 ps=0
M1122 p1p0c0 a_20_n868# vdd w_7_n874# CMOSP w=20 l=2
+  ad=100 pd=50 as=0 ps=0
M1123 a_n349_595# a4 gnd Gnd CMOSN w=20 l=2
+  ad=200 pd=60 as=0 ps=0
M1124 a_n561_143# clk gnd Gnd CMOSN w=10 l=2
+  ad=0 pd=0 as=0 ps=0
M1125 c3 a_316_n332# vdd vdd CMOSP w=20 l=2
+  ad=100 pd=50 as=0 ps=0
M1126 a_480_625# p4 vdd w_467_619# CMOSP w=20 l=2
+  ad=200 pd=60 as=0 ps=0
M1127 gnd p2 a_1119_n353# Gnd CMOSN w=20 l=2
+  ad=0 pd=0 as=0 ps=0
M1128 gnd a0bar a_n276_n1362# Gnd CMOSN w=20 l=2
+  ad=0 pd=0 as=200 ps=60
M1129 a_140_n799# p1p0c0 gnd Gnd CMOSN w=10 l=2
+  ad=0 pd=0 as=0 ps=0
M1130 a_n598_n868# b1d gnd Gnd CMOSN w=10 l=2
+  ad=50 pd=30 as=0 ps=0
M1131 b1 a_n530_n837# vdd vdd CMOSP w=20 l=2
+  ad=100 pd=50 as=0 ps=0
M1132 a_172_n467# p2 gnd Gnd CMOSN w=20 l=2
+  ad=200 pd=60 as=0 ps=0
M1133 a_n531_n375# clk a_n531_n406# Gnd CMOSN w=10 l=2
+  ad=50 pd=30 as=100 ps=40
M1134 p4p3p2p1g0 a_480_625# vdd w_467_619# CMOSP w=20 l=2
+  ad=100 pd=50 as=0 ps=0
M1135 a_n599_n406# clk a_n599_n375# vdd CMOSP w=20 l=2
+  ad=100 pd=50 as=200 ps=60
M1136 a_1104_105# a_978_54# gnd Gnd CMOSN w=20 l=2
+  ad=200 pd=60 as=0 ps=0
M1137 vdd p0 a_n108_n1183# w_n121_n1189# CMOSP w=20 l=2
+  ad=0 pd=0 as=200 ps=60
M1138 a_20_n868# p0c0 a_20_n913# Gnd CMOSN w=20 l=2
+  ad=100 pd=50 as=200 ps=60
M1139 a_n531_n375# a_n564_n375# vdd vdd CMOSP w=20 l=2
+  ad=100 pd=50 as=0 ps=0
M1140 a_n108_n1228# c0 gnd Gnd CMOSN w=20 l=2
+  ad=200 pd=60 as=0 ps=0
M1141 s0 a_905_n1220# a_1033_n1285# Gnd CMOSN w=20 l=2
+  ad=200 pd=60 as=200 ps=60
M1142 a_1395_n1243# a_1362_n1243# vdd vdd CMOSP w=20 l=2
+  ad=100 pd=50 as=0 ps=0
M1143 a_135_1# a_139_n20# a_135_n44# Gnd CMOSN w=20 l=2
+  ad=100 pd=50 as=0 ps=0
M1144 a_n377_n1201# a0 vdd w_n390_n1207# CMOSP w=20 l=2
+  ad=200 pd=60 as=0 ps=0
M1145 a_1362_n1243# clk vdd vdd CMOSP w=20 l=2
+  ad=100 pd=50 as=0 ps=0
M1146 gnd p3p2p1g0 a_370_99# Gnd CMOSN w=10 l=2
+  ad=0 pd=0 as=250 ps=110
M1147 a_480_580# p4 gnd Gnd CMOSN w=20 l=2
+  ad=200 pd=60 as=0 ps=0
M1148 a_652_501# p4 vdd w_639_495# CMOSP w=20 l=2
+  ad=200 pd=60 as=0 ps=0
M1149 a_1124_545# a_998_494# gnd Gnd CMOSN w=20 l=2
+  ad=200 pd=60 as=0 ps=0
M1150 a_998_494# c4 vdd w_984_517# CMOSP w=20 l=2
+  ad=100 pd=50 as=0 ps=0
M1151 p4p3p2p1p0c0 a_652_501# vdd w_639_495# CMOSP w=20 l=2
+  ad=100 pd=50 as=0 ps=0
M1152 a_n568_551# b4d vdd vdd CMOSP w=20 l=2
+  ad=0 pd=0 as=0 ps=0
M1153 a_263_n86# p3 vdd w_250_n92# CMOSP w=20 l=2
+  ad=200 pd=60 as=0 ps=0
M1154 a_n302_65# a3 vdd vdd CMOSP w=40 l=2
+  ad=0 pd=0 as=0 ps=0
M1155 a_n532_n734# clk a_n532_n765# Gnd CMOSN w=10 l=2
+  ad=50 pd=30 as=100 ps=40
M1156 a_1400_n297# clk a_1400_n328# Gnd CMOSN w=10 l=2
+  ad=50 pd=30 as=0 ps=0
M1157 b4bar b4 gnd Gnd CMOSN w=10 l=2
+  ad=50 pd=30 as=0 ps=0
M1158 a3 a_n528_174# gnd Gnd CMOSN w=10 l=2
+  ad=50 pd=30 as=0 ps=0
M1159 a_1335_133# s3 gnd Gnd CMOSN w=10 l=2
+  ad=50 pd=30 as=0 ps=0
M1160 a_n379_161# a3 vdd w_n392_155# CMOSP w=20 l=2
+  ad=200 pd=60 as=0 ps=0
M1161 a_n563_n837# a_n598_n868# a_n563_n868# Gnd CMOSN w=10 l=2
+  ad=50 pd=30 as=100 ps=40
M1162 a_1104_170# a_976_170# vdd vdd CMOSP w=40 l=2
+  ad=400 pd=100 as=0 ps=0
M1163 vdd g3 a_118_889# w_105_883# CMOSP w=20 l=2
+  ad=0 pd=0 as=0 ps=0
M1164 a_1029_813# clk a_1029_844# vdd CMOSP w=20 l=2
+  ad=100 pd=50 as=0 ps=0
M1165 a_n380_n331# a2 gnd Gnd CMOSN w=20 l=2
+  ad=200 pd=60 as=0 ps=0
M1166 a_n596_143# clk a_n596_174# vdd CMOSP w=20 l=2
+  ad=100 pd=50 as=200 ps=60
M1167 a_237_808# p4 vdd w_224_802# CMOSP w=20 l=2
+  ad=200 pd=60 as=0 ps=0
M1168 a_n530_n1184# clk a_n530_n1215# Gnd CMOSN w=10 l=2
+  ad=50 pd=30 as=0 ps=0
M1169 g4 a_n349_640# gnd Gnd CMOSN w=10 l=2
+  ad=50 pd=30 as=0 ps=0
M1170 a_29_n339# p1g0 a_29_n384# Gnd CMOSN w=20 l=2
+  ad=100 pd=50 as=0 ps=0
M1171 a_352_712# p4 vdd w_339_706# CMOSP w=20 l=2
+  ad=200 pd=60 as=0 ps=0
M1172 a_n531_653# clk vdd vdd CMOSP w=20 l=2
+  ad=100 pd=50 as=0 ps=0
M1173 p4p3p2g1 a_352_712# vdd w_339_706# CMOSP w=20 l=2
+  ad=100 pd=50 as=0 ps=0
M1174 a_1355_573# s4 gnd Gnd CMOSN w=10 l=2
+  ad=50 pd=30 as=0 ps=0
M1175 g2 a_n380_n286# vdd w_n393_n292# CMOSP w=20 l=2
+  ad=100 pd=50 as=0 ps=0
M1176 b1 a_n530_n837# gnd Gnd CMOSN w=10 l=2
+  ad=50 pd=30 as=0 ps=0
M1177 a_1119_n288# p2 s2 vdd CMOSP w=40 l=2
+  ad=400 pd=100 as=0 ps=0
M1178 a_n81_n776# p1 vdd w_n94_n782# CMOSP w=20 l=2
+  ad=0 pd=0 as=0 ps=0
M1179 a_976_170# p3 vdd w_962_193# CMOSP w=20 l=2
+  ad=100 pd=50 as=0 ps=0
M1180 a_n498_653# clk a_n498_622# Gnd CMOSN w=10 l=2
+  ad=50 pd=30 as=100 ps=40
M1181 p0 b0bar a_n300_n1297# vdd CMOSP w=40 l=2
+  ad=400 pd=100 as=0 ps=0
M1182 p4 a4 a_n272_479# Gnd CMOSN w=20 l=2
+  ad=200 pd=60 as=200 ps=60
M1183 a_n597_n1294# b0d vdd vdd CMOSP w=20 l=2
+  ad=0 pd=0 as=0 ps=0
M1184 a_1390_604# a_1355_573# a_1390_573# Gnd CMOSN w=10 l=2
+  ad=50 pd=30 as=0 ps=0
M1185 a_n530_n304# a_n563_n273# gnd Gnd CMOSN w=10 l=2
+  ad=100 pd=40 as=0 ps=0
M1186 a_237_763# p4 gnd Gnd CMOSN w=20 l=2
+  ad=200 pd=60 as=0 ps=0
M1187 a_n600_n765# clk a_n600_n734# vdd CMOSP w=20 l=2
+  ad=100 pd=50 as=200 ps=60
M1188 vdd g2 a_n99_178# w_n112_172# CMOSP w=20 l=2
+  ad=0 pd=0 as=200 ps=60
M1189 a_20_n913# p1 gnd Gnd CMOSN w=20 l=2
+  ad=0 pd=0 as=0 ps=0
M1190 a_1362_n1274# clk gnd Gnd CMOSN w=10 l=2
+  ad=100 pd=40 as=0 ps=0
M1191 a_1395_n1274# a_1362_n1243# gnd Gnd CMOSN w=10 l=2
+  ad=100 pd=40 as=0 ps=0
M1192 a4bar a4 vdd w_n418_702# CMOSP w=20 l=2
+  ad=100 pd=50 as=0 ps=0
M1193 a_n598_n273# a2d vdd vdd CMOSP w=20 l=2
+  ad=0 pd=0 as=0 ps=0
M1194 a_n532_n734# a_n565_n734# vdd vdd CMOSP w=20 l=2
+  ad=100 pd=50 as=0 ps=0
M1195 a_996_610# p4 vdd w_982_633# CMOSP w=20 l=2
+  ad=100 pd=50 as=0 ps=0
M1196 b0 a_n529_n1294# vdd vdd CMOSP w=20 l=2
+  ad=100 pd=50 as=0 ps=0
M1197 b3 a_n530_72# vdd vdd CMOSP w=20 l=2
+  ad=100 pd=50 as=0 ps=0
M1198 a_370_99# p3p2p1p0c0 gnd Gnd CMOSN w=10 l=2
+  ad=0 pd=0 as=0 ps=0
M1199 a_n563_n837# clk vdd vdd CMOSP w=20 l=2
+  ad=100 pd=50 as=0 ps=0
M1200 b3bar b3 vdd w_n449_11# CMOSP w=20 l=2
+  ad=100 pd=50 as=0 ps=0
M1201 a_1124_610# a_996_610# vdd vdd CMOSP w=40 l=2
+  ad=400 pd=100 as=0 ps=0
M1202 a4 a_n498_653# vdd vdd CMOSP w=20 l=2
+  ad=100 pd=50 as=0 ps=0
M1203 vdd b1 a_n378_n747# w_n391_n753# CMOSP w=20 l=2
+  ad=0 pd=0 as=200 ps=60
M1204 p4g3 a_118_889# gnd Gnd CMOSN w=10 l=2
+  ad=50 pd=30 as=0 ps=0
M1205 b0bar b0 vdd w_n447_n1351# CMOSP w=20 l=2
+  ad=100 pd=50 as=0 ps=0
M1206 s0q a_1395_n1243# vdd vdd CMOSP w=20 l=2
+  ad=100 pd=50 as=0 ps=0
M1207 a_n563_72# a_n598_41# a_n563_41# Gnd CMOSN w=10 l=2
+  ad=50 pd=30 as=100 ps=40
M1208 a_n377_n1201# b0 a_n377_n1246# Gnd CMOSN w=20 l=2
+  ad=100 pd=50 as=200 ps=60
M1209 a_382_161# p3g2 a_370_161# vdd CMOSP w=100 l=2
+  ad=1000 pd=220 as=0 ps=0
M1210 a_118_889# g3 a_118_844# Gnd CMOSN w=20 l=2
+  ad=100 pd=50 as=0 ps=0
M1211 a_172_n422# p1p0c0 a_172_n467# Gnd CMOSN w=20 l=2
+  ad=100 pd=50 as=0 ps=0
M1212 a_n531_n406# a_n564_n375# gnd Gnd CMOSN w=10 l=2
+  ad=0 pd=0 as=0 ps=0
M1213 a_n380_n286# b2 a_n380_n331# Gnd CMOSN w=20 l=2
+  ad=100 pd=50 as=0 ps=0
M1214 a_967_n288# p2 gnd Gnd CMOSN w=10 l=2
+  ad=50 pd=30 as=0 ps=0
M1215 p0c0 a_n108_n1183# gnd Gnd CMOSN w=10 l=2
+  ad=50 pd=30 as=0 ps=0
M1216 vdd a_907_n1336# a_1057_n1220# vdd CMOSP w=40 l=2
+  ad=0 pd=0 as=0 ps=0
M1217 a_1327_n1243# s0 vdd vdd CMOSP w=20 l=2
+  ad=200 pd=60 as=0 ps=0
M1218 a_1095_n353# a_969_n404# gnd Gnd CMOSN w=20 l=2
+  ad=0 pd=0 as=0 ps=0
M1219 g3 a_n379_161# vdd w_n392_155# CMOSP w=20 l=2
+  ad=100 pd=50 as=0 ps=0
M1220 a2bar a2 vdd w_n449_n224# CMOSP w=20 l=2
+  ad=100 pd=50 as=0 ps=0
M1221 c5 a_1097_844# gnd Gnd CMOSN w=10 l=2
+  ad=50 pd=30 as=0 ps=0
M1222 b1bar b1 vdd w_n448_n897# CMOSP w=20 l=2
+  ad=100 pd=50 as=0 ps=0
M1223 a_969_n404# c2 gnd Gnd CMOSN w=10 l=2
+  ad=50 pd=30 as=0 ps=0
M1224 c1 a_8_n1314# vdd vdd CMOSP w=20 l=2
+  ad=100 pd=50 as=0 ps=0
M1225 a_n530_n273# clk a_n530_n304# Gnd CMOSN w=10 l=2
+  ad=50 pd=30 as=0 ps=0
M1226 a_n99_178# g2 a_n99_133# Gnd CMOSN w=20 l=2
+  ad=100 pd=50 as=200 ps=60
M1227 p4 b4bar a_n272_544# vdd CMOSP w=40 l=2
+  ad=0 pd=0 as=400 ps=100
M1228 s3 a_976_170# a_1104_105# Gnd CMOSN w=20 l=2
+  ad=200 pd=60 as=0 ps=0
M1229 p4p3p2p1g0 a_480_625# gnd Gnd CMOSN w=10 l=2
+  ad=50 pd=30 as=0 ps=0
M1230 a_n598_n1184# a0d vdd vdd CMOSP w=20 l=2
+  ad=0 pd=0 as=0 ps=0
M1231 a_n528_174# clk a_n528_143# Gnd CMOSN w=10 l=2
+  ad=50 pd=30 as=100 ps=40
M1232 a_n532_n765# a_n565_n734# gnd Gnd CMOSN w=10 l=2
+  ad=0 pd=0 as=0 ps=0
M1233 a2 a_n530_n273# vdd vdd CMOSP w=20 l=2
+  ad=100 pd=50 as=0 ps=0
M1234 a_n533_551# clk vdd vdd CMOSP w=20 l=2
+  ad=100 pd=50 as=0 ps=0
M1235 a_n645_n1041# a_n680_n1072# a_n645_n1072# Gnd CMOSN w=10 l=2
+  ad=50 pd=30 as=100 ps=40
M1236 a_n612_n1041# clk a_n612_n1072# Gnd CMOSN w=10 l=2
+  ad=50 pd=30 as=100 ps=40
M1237 a_n563_n868# clk gnd Gnd CMOSN w=10 l=2
+  ad=0 pd=0 as=0 ps=0
M1238 vdd a_656_480# a_652_501# w_639_495# CMOSP w=20 l=2
+  ad=0 pd=0 as=0 ps=0
M1239 s4 a_996_610# a_1124_545# Gnd CMOSN w=20 l=2
+  ad=200 pd=60 as=0 ps=0
M1240 a0 a_n530_n1184# vdd vdd CMOSP w=20 l=2
+  ad=100 pd=50 as=0 ps=0
M1241 a_1403_133# a_1370_164# gnd Gnd CMOSN w=10 l=2
+  ad=100 pd=40 as=0 ps=0
M1242 vdd p2p1p0c0 a_263_n86# w_250_n92# CMOSP w=20 l=2
+  ad=0 pd=0 as=0 ps=0
M1243 p2p1g0 a_29_n339# gnd Gnd CMOSN w=10 l=2
+  ad=50 pd=30 as=0 ps=0
M1244 a_998_494# c4 gnd Gnd CMOSN w=10 l=2
+  ad=50 pd=30 as=0 ps=0
M1245 a3bar a3 vdd w_n448_223# CMOSP w=20 l=2
+  ad=100 pd=50 as=0 ps=0
M1246 p4p3p2p1p0c0 a_652_501# gnd Gnd CMOSN w=10 l=2
+  ad=50 pd=30 as=0 ps=0
M1247 a_n500_551# clk a_n500_520# Gnd CMOSN w=10 l=2
+  ad=50 pd=30 as=100 ps=40
M1248 c2 a_140_n799# vdd vdd CMOSP w=20 l=2
+  ad=100 pd=50 as=0 ps=0
M1249 a_n597_n1325# b0d gnd Gnd CMOSN w=10 l=2
+  ad=50 pd=30 as=0 ps=0
M1250 s0q a_1395_n1243# gnd Gnd CMOSN w=10 l=2
+  ad=50 pd=30 as=0 ps=0
M1251 vdd a_969_n404# a_1119_n288# vdd CMOSP w=40 l=2
+  ad=0 pd=0 as=0 ps=0
M1252 a_1423_573# a_1390_604# gnd Gnd CMOSN w=10 l=2
+  ad=100 pd=40 as=0 ps=0
M1253 vdd a0bar a_n276_n1297# vdd CMOSP w=40 l=2
+  ad=0 pd=0 as=400 ps=100
M1254 a_1370_n833# a_1335_n864# a_1370_n864# Gnd CMOSN w=10 l=2
+  ad=50 pd=30 as=100 ps=40
M1255 s3 c3 a_1104_170# vdd CMOSP w=40 l=2
+  ad=400 pd=100 as=0 ps=0
M1256 a_n599_n375# b2d vdd vdd CMOSP w=20 l=2
+  ad=0 pd=0 as=0 ps=0
M1257 a_n598_n304# a2d gnd Gnd CMOSN w=10 l=2
+  ad=50 pd=30 as=0 ps=0
M1258 a_n563_41# clk gnd Gnd CMOSN w=10 l=2
+  ad=0 pd=0 as=0 ps=0
M1259 vdd a_241_787# a_237_808# w_224_802# CMOSP w=20 l=2
+  ad=0 pd=0 as=0 ps=0
M1260 vdd b4 a_n349_640# w_n362_634# CMOSP w=20 l=2
+  ad=0 pd=0 as=0 ps=0
M1261 a_1370_n833# clk vdd vdd CMOSP w=20 l=2
+  ad=100 pd=50 as=0 ps=0
M1262 a_n596_174# a3d vdd vdd CMOSP w=20 l=2
+  ad=0 pd=0 as=0 ps=0
M1263 vdd a_356_691# a_352_712# w_339_706# CMOSP w=20 l=2
+  ad=0 pd=0 as=0 ps=0
M1264 b0 a_n529_n1294# gnd Gnd CMOSN w=10 l=2
+  ad=50 pd=30 as=0 ps=0
M1265 p2g1 a_n102_n267# gnd Gnd CMOSN w=10 l=2
+  ad=50 pd=30 as=0 ps=0
M1266 s3q a_1403_164# vdd vdd CMOSP w=20 l=2
+  ad=100 pd=50 as=0 ps=0
M1267 a_1327_n1274# s0 gnd Gnd CMOSN w=10 l=2
+  ad=50 pd=30 as=0 ps=0
M1268 p2p1p0c0 a_172_n422# vdd w_159_n428# CMOSP w=20 l=2
+  ad=100 pd=50 as=0 ps=0
M1269 a_n279_n447# b2bar p2 Gnd CMOSN w=20 l=2
+  ad=200 pd=60 as=200 ps=60
M1270 p4p3p2g1 a_352_712# gnd Gnd CMOSN w=10 l=2
+  ad=50 pd=30 as=0 ps=0
M1271 a_n301_n908# b1 gnd Gnd CMOSN w=20 l=2
+  ad=0 pd=0 as=0 ps=0
M1272 b4 a_n500_551# vdd vdd CMOSP w=20 l=2
+  ad=100 pd=50 as=0 ps=0
M1273 a_406_161# p3p2p1g0 a_394_161# vdd CMOSP w=100 l=2
+  ad=1000 pd=220 as=1000 ps=220
M1274 a_n498_622# a_n531_653# gnd Gnd CMOSN w=10 l=2
+  ad=0 pd=0 as=0 ps=0
M1275 a_n279_n382# b2 p2 vdd CMOSP w=40 l=2
+  ad=400 pd=100 as=400 ps=100
M1276 a_n272_479# b4 gnd Gnd CMOSN w=20 l=2
+  ad=0 pd=0 as=0 ps=0
M1277 b2bar b2 gnd Gnd CMOSN w=10 l=2
+  ad=50 pd=30 as=0 ps=0
M1278 a_n301_n843# a1 vdd vdd CMOSP w=40 l=2
+  ad=0 pd=0 as=0 ps=0
M1279 a_1367_n297# clk vdd vdd CMOSP w=20 l=2
+  ad=100 pd=50 as=0 ps=0
M1280 p3p2p1p0c0 a_263_n86# gnd Gnd CMOSN w=10 l=2
+  ad=50 pd=30 as=0 ps=0
M1281 a_976_170# p3 gnd Gnd CMOSN w=10 l=2
+  ad=50 pd=30 as=0 ps=0
M1282 a_n81_n776# g0 a_n81_n821# Gnd CMOSN w=20 l=2
+  ad=100 pd=50 as=200 ps=60
M1283 a_1097_844# a_1064_844# vdd vdd CMOSP w=20 l=2
+  ad=100 pd=50 as=0 ps=0
M1284 a_237_808# a_241_787# a_237_763# Gnd CMOSN w=20 l=2
+  ad=100 pd=50 as=0 ps=0
M1285 a_135_1# p3 vdd w_122_n5# CMOSP w=20 l=2
+  ad=200 pd=60 as=0 ps=0
M1286 a_n378_n747# a1 vdd w_n391_n753# CMOSP w=20 l=2
+  ad=0 pd=0 as=0 ps=0
M1287 a_n562_n1294# a_n597_n1325# a_n562_n1325# Gnd CMOSN w=10 l=2
+  ad=50 pd=30 as=0 ps=0
M1288 a4bar a4 gnd Gnd CMOSN w=10 l=2
+  ad=50 pd=30 as=0 ps=0
M1289 a_652_456# p4 gnd Gnd CMOSN w=20 l=2
+  ad=200 pd=60 as=0 ps=0
M1290 a_n563_n273# a_n598_n304# a_n563_n304# Gnd CMOSN w=10 l=2
+  ad=50 pd=30 as=100 ps=40
M1291 s0 p0 a_1033_n1220# vdd CMOSP w=40 l=2
+  ad=0 pd=0 as=0 ps=0
M1292 s4 c4 a_1124_610# vdd CMOSP w=40 l=2
+  ad=400 pd=100 as=0 ps=0
M1293 vdd g1 a_n102_n267# w_n115_n273# CMOSP w=20 l=2
+  ad=0 pd=0 as=200 ps=60
M1294 a_1370_164# clk vdd vdd CMOSP w=20 l=2
+  ad=100 pd=50 as=0 ps=0
M1295 a_1370_164# a_1335_133# a_1370_133# Gnd CMOSN w=10 l=2
+  ad=50 pd=30 as=0 ps=0
M1296 p4p3g2 a_237_808# vdd w_224_802# CMOSP w=20 l=2
+  ad=100 pd=50 as=0 ps=0
M1297 a_20_97# p3 vdd w_7_91# CMOSP w=20 l=2
+  ad=200 pd=60 as=0 ps=0
M1298 s4q a_1423_604# vdd vdd CMOSP w=20 l=2
+  ad=100 pd=50 as=0 ps=0
M1299 a_n598_n1215# a0d gnd Gnd CMOSN w=10 l=2
+  ad=50 pd=30 as=0 ps=0
M1300 a_n563_n273# clk vdd vdd CMOSP w=20 l=2
+  ad=100 pd=50 as=0 ps=0
M1301 a_394_161# p3p2g1 a_382_161# vdd CMOSP w=100 l=2
+  ad=0 pd=0 as=0 ps=0
M1302 a_1370_n864# clk gnd Gnd CMOSN w=10 l=2
+  ad=0 pd=0 as=0 ps=0
M1303 a2 a_n530_n273# gnd Gnd CMOSN w=10 l=2
+  ad=50 pd=30 as=0 ps=0
M1304 b2 a_n531_n375# vdd vdd CMOSP w=20 l=2
+  ad=100 pd=50 as=0 ps=0
M1305 p3 a3 a_n302_0# Gnd CMOSN w=20 l=2
+  ad=0 pd=0 as=200 ps=60
M1306 a_352_667# p4 gnd Gnd CMOSN w=20 l=2
+  ad=200 pd=60 as=0 ps=0
M1307 a_n600_n734# a1d vdd vdd CMOSP w=20 l=2
+  ad=0 pd=0 as=0 ps=0
M1308 a_929_n797# p1 gnd Gnd CMOSN w=10 l=2
+  ad=50 pd=30 as=0 ps=0
M1309 a0 a_n530_n1184# gnd Gnd CMOSN w=10 l=2
+  ad=50 pd=30 as=0 ps=0
M1310 gnd a2bar a_n279_n447# Gnd CMOSN w=20 l=2
+  ad=0 pd=0 as=0 ps=0
M1311 a_996_610# p4 gnd Gnd CMOSN w=10 l=2
+  ad=50 pd=30 as=0 ps=0
M1312 a_1057_n862# a_931_n913# gnd Gnd CMOSN w=20 l=2
+  ad=200 pd=60 as=0 ps=0
M1313 a_n564_n375# a_n599_n406# a_n564_n406# Gnd CMOSN w=10 l=2
+  ad=50 pd=30 as=100 ps=40
M1314 p1p0c0 a_20_n868# gnd Gnd CMOSN w=10 l=2
+  ad=50 pd=30 as=0 ps=0
M1315 vdd a2bar a_n279_n382# vdd CMOSP w=40 l=2
+  ad=0 pd=0 as=0 ps=0
M1316 a_n598_41# b3d gnd Gnd CMOSN w=10 l=2
+  ad=50 pd=30 as=0 ps=0
M1317 a_931_n913# c1 gnd Gnd CMOSN w=10 l=2
+  ad=50 pd=30 as=0 ps=0
M1318 a0bar a0 vdd w_n446_n1139# CMOSP w=20 l=2
+  ad=100 pd=50 as=0 ps=0
M1319 a_1128_105# c3 s3 Gnd CMOSN w=20 l=2
+  ad=200 pd=60 as=0 ps=0
M1320 a_n272_544# a4 vdd vdd CMOSP w=40 l=2
+  ad=0 pd=0 as=0 ps=0
M1321 a_905_n1220# c0 vdd w_891_n1197# CMOSP w=20 l=2
+  ad=100 pd=50 as=0 ps=0
M1322 s1q a_1403_n833# vdd vdd CMOSP w=20 l=2
+  ad=100 pd=50 as=0 ps=0
M1323 a_n564_n375# clk vdd vdd CMOSP w=20 l=2
+  ad=100 pd=50 as=0 ps=0
M1324 a_n379_116# a3 gnd Gnd CMOSN w=20 l=2
+  ad=0 pd=0 as=0 ps=0
M1325 a_n528_143# a_n561_174# gnd Gnd CMOSN w=10 l=2
+  ad=0 pd=0 as=0 ps=0
M1326 a_n599_n406# b2d gnd Gnd CMOSN w=10 l=2
+  ad=50 pd=30 as=0 ps=0
M1327 vdd p2g1 a_20_97# w_7_91# CMOSP w=20 l=2
+  ad=0 pd=0 as=0 ps=0
M1328 a_1390_604# clk vdd vdd CMOSP w=20 l=2
+  ad=100 pd=50 as=0 ps=0
M1329 a_n680_n1041# c0d vdd vdd CMOSP w=20 l=2
+  ad=200 pd=60 as=0 ps=0
M1330 a_n563_n1184# a_n598_n1215# a_n563_n1215# Gnd CMOSN w=10 l=2
+  ad=50 pd=30 as=0 ps=0
M1331 vdd a_139_n20# a_135_1# w_122_n5# CMOSP w=20 l=2
+  ad=0 pd=0 as=0 ps=0
M1332 a_1148_545# c4 s4 Gnd CMOSN w=20 l=2
+  ad=200 pd=60 as=0 ps=0
M1333 a_1403_164# clk a_1403_133# Gnd CMOSN w=10 l=2
+  ad=50 pd=30 as=0 ps=0
M1334 a_n108_n1183# c0 vdd w_n121_n1189# CMOSP w=20 l=2
+  ad=0 pd=0 as=0 ps=0
M1335 a_n302_0# b3 gnd Gnd CMOSN w=20 l=2
+  ad=0 pd=0 as=0 ps=0
M1336 a_n276_n1362# b0bar p0 Gnd CMOSN w=20 l=2
+  ad=0 pd=0 as=0 ps=0
M1337 a_n565_n734# a_n600_n765# a_n565_n765# Gnd CMOSN w=10 l=2
+  ad=50 pd=30 as=100 ps=40
M1338 a_1395_n1243# clk a_1395_n1274# Gnd CMOSN w=10 l=2
+  ad=50 pd=30 as=0 ps=0
M1339 s2q a_1400_n297# vdd vdd CMOSP w=20 l=2
+  ad=100 pd=50 as=0 ps=0
M1340 a_20_52# p3 gnd Gnd CMOSN w=20 l=2
+  ad=200 pd=60 as=0 ps=0
M1341 a_1367_n328# clk gnd Gnd CMOSN w=10 l=2
+  ad=100 pd=40 as=0 ps=0
M1342 a_n530_72# clk a_n530_41# Gnd CMOSN w=10 l=2
+  ad=50 pd=30 as=100 ps=40
M1343 c0 a_n612_n1041# vdd vdd CMOSP w=20 l=2
+  ad=100 pd=50 as=0 ps=0
M1344 a_1029_813# a_1023_826# gnd Gnd CMOSN w=10 l=2
+  ad=50 pd=30 as=0 ps=0
M1345 p2 a2 a_n303_n447# Gnd CMOSN w=20 l=2
+  ad=0 pd=0 as=0 ps=0
M1346 g3 a_n379_161# gnd Gnd CMOSN w=10 l=2
+  ad=50 pd=30 as=0 ps=0
M1347 c3 a_316_n332# gnd Gnd CMOSN w=10 l=2
+  ad=50 pd=30 as=0 ps=0
M1348 a_1095_n288# a_967_n288# vdd vdd CMOSP w=40 l=2
+  ad=0 pd=0 as=0 ps=0
M1349 a_n561_174# clk vdd vdd CMOSP w=20 l=2
+  ad=100 pd=50 as=0 ps=0
M1350 a_n500_520# a_n533_551# gnd Gnd CMOSN w=10 l=2
+  ad=0 pd=0 as=0 ps=0
M1351 g1 a_n378_n747# vdd w_n391_n753# CMOSP w=20 l=2
+  ad=100 pd=50 as=0 ps=0
M1352 a_316_n283# p2p1p0c0 vdd vdd CMOSP w=80 l=2
+  ad=800 pd=180 as=0 ps=0
M1353 a_1423_604# clk a_1423_573# Gnd CMOSN w=10 l=2
+  ad=50 pd=30 as=0 ps=0
M1354 a_n531_653# a_n566_622# a_n531_622# Gnd CMOSN w=10 l=2
+  ad=50 pd=30 as=100 ps=40
M1355 vdd a_484_604# a_480_625# w_467_619# CMOSP w=20 l=2
+  ad=0 pd=0 as=0 ps=0
M1356 a_1057_n1285# p0 s0 Gnd CMOSN w=20 l=2
+  ad=0 pd=0 as=0 ps=0
M1357 a_n600_n765# a1d gnd Gnd CMOSN w=10 l=2
+  ad=50 pd=30 as=0 ps=0
M1358 a_1128_170# p3 s3 vdd CMOSP w=40 l=2
+  ad=400 pd=100 as=0 ps=0
M1359 a1 a_n532_n734# vdd vdd CMOSP w=20 l=2
+  ad=100 pd=50 as=0 ps=0
M1360 a_172_n422# p2 vdd w_159_n428# CMOSP w=20 l=2
+  ad=200 pd=60 as=0 ps=0
M1361 p2 b2bar a_n303_n382# vdd CMOSP w=40 l=2
+  ad=0 pd=0 as=0 ps=0
M1362 a_n566_622# a4d gnd Gnd CMOSN w=10 l=2
+  ad=50 pd=30 as=0 ps=0
M1363 a_n81_n821# p1 gnd Gnd CMOSN w=20 l=2
+  ad=0 pd=0 as=0 ps=0
M1364 a_n378_n747# b1 a_n378_n792# Gnd CMOSN w=20 l=2
+  ad=100 pd=50 as=200 ps=60
M1365 gnd a4bar a_n248_479# Gnd CMOSN w=20 l=2
+  ad=0 pd=0 as=200 ps=60
M1366 c4 a_370_99# vdd vdd CMOSP w=20 l=2
+  ad=100 pd=50 as=0 ps=0
M1367 p3p2g1 a_20_97# vdd w_7_91# CMOSP w=20 l=2
+  ad=100 pd=50 as=0 ps=0
M1368 p1g0 a_n81_n776# vdd w_n94_n782# CMOSP w=20 l=2
+  ad=100 pd=50 as=0 ps=0
M1369 a_370_99# p3p2p1p0c0 a_406_161# vdd CMOSP w=100 l=2
+  ad=500 pd=210 as=0 ps=0
M1370 a3bar a3 gnd Gnd CMOSN w=10 l=2
+  ad=50 pd=30 as=0 ps=0
M1371 s1q a_1403_n833# gnd Gnd CMOSN w=10 l=2
+  ad=50 pd=30 as=0 ps=0
M1372 a_n563_n304# clk gnd Gnd CMOSN w=10 l=2
+  ad=0 pd=0 as=0 ps=0
M1373 a_480_625# a_484_604# a_480_580# Gnd CMOSN w=20 l=2
+  ad=100 pd=50 as=0 ps=0
M1374 a_1335_n833# s1 vdd vdd CMOSP w=20 l=2
+  ad=200 pd=60 as=0 ps=0
M1375 a1bar a1 vdd w_n447_n685# CMOSP w=20 l=2
+  ad=100 pd=50 as=0 ps=0
M1376 a_n99_178# p3 vdd w_n112_172# CMOSP w=20 l=2
+  ad=0 pd=0 as=0 ps=0
M1377 b2 a_n531_n375# gnd Gnd CMOSN w=10 l=2
+  ad=50 pd=30 as=0 ps=0
M1378 a_20_97# p2g1 a_20_52# Gnd CMOSN w=20 l=2
+  ad=100 pd=50 as=0 ps=0
M1379 a_n530_41# a_n563_72# gnd Gnd CMOSN w=10 l=2
+  ad=0 pd=0 as=0 ps=0
M1380 a_n300_n1362# b0 gnd Gnd CMOSN w=20 l=2
+  ad=0 pd=0 as=0 ps=0
M1381 a_n565_n734# clk vdd vdd CMOSP w=20 l=2
+  ad=100 pd=50 as=0 ps=0
M1382 a_n680_n1072# c0d gnd Gnd CMOSN w=10 l=2
+  ad=50 pd=30 as=0 ps=0
M1383 g0 a_n377_n1201# vdd w_n390_n1207# CMOSP w=20 l=2
+  ad=100 pd=50 as=0 ps=0
M1384 a3 a_n528_174# vdd vdd CMOSP w=20 l=2
+  ad=100 pd=50 as=0 ps=0
M1385 a_652_501# a_656_480# a_652_456# Gnd CMOSN w=20 l=2
+  ad=100 pd=50 as=0 ps=0
M1386 a_370_99# g3 gnd Gnd CMOSN w=10 l=2
+  ad=0 pd=0 as=0 ps=0
M1387 a_1335_164# s3 vdd vdd CMOSP w=20 l=2
+  ad=0 pd=0 as=0 ps=0
M1388 a_1064_813# clk gnd Gnd CMOSN w=10 l=2
+  ad=0 pd=0 as=0 ps=0
M1389 a_1332_n297# s2 vdd vdd CMOSP w=20 l=2
+  ad=200 pd=60 as=0 ps=0
M1390 a_1148_610# p4 s4 vdd CMOSP w=40 l=2
+  ad=0 pd=0 as=0 ps=0
M1391 c0 a_n612_n1041# gnd Gnd CMOSN w=10 l=2
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
